wangxy0803/De/paper.pdf

# Design and Kinematic Analysis of a 6-DoF Parallel Robot for Image-guided Surgery

1

st Xiyu Wang
School of Intelligent Systems Engineering Shenzhen Campus of Sun Yat-sen University Shenzhen, China
wangxy623@mail2.sysu.edu.cn

3

rd Zhijie Pan
School of Intelligent Systems Engineering Shenzhen Campus of Sun Yat-sen University Shenzhen, China
panzhj6@mail2.sysu.edu.cn

5

th Ruchi Guo
Department of Mathematics
University of California, Irvine Irvine, USA
ruchig@uci.edu

2

nd Yongyin Ye
School of Intelligent Systems Engineering Shenzhen Campus of Sun Yat-sen University Shenzhen, China
yeyy33@mail2.sysu.edu.cn

4

th Jiangnan Wang
School of Intelligent Systems Engineering Shenzhen Campus of Sun Yat-sen University Shenzhen, China
wangjn229@mail2.sysu.edu.cn

6

th Mengtang Li
School of Intelligent Systems Engineering Shenzhen Campus of Sun Yat-sen University Shenzhen, China
limt29@mail.sysu.edu.cn

Abstract—Image-guided robot based on medical imaging is extensively utilized in the field of surgery due to its inherent characteristics of enhanced precision and larger accessible workspace than surgeons, resulting in reduced harm to patients. Nevertheless, the robots currently employed in image-guided surgery are either insufficiently stable serial robots or parallel robots that pose difficulties in computing direct kinematics. As an improvement to current robot-assisted surgical systems, a compact six degrees of freedom (DoF) decoupled parallel robot has been proposed and corresponding kinematic model has been established. Furthermore, an algorithm based on Newton iterative method is employed to solve the forward kinematics problem. Finally, simulated neurosurgical experiments are carried out to display the trajectory of motion planning and to verify the correctness of kinematics. Experiment results demonstrate that the proposed parallel robot can achieve satisfactory performance.

Index Terms—Image-guided robot; Parallel robot; Robot kinematics.

I. INTRODUCTION
Image-guided surgery is considered a multidisciplinary field that combines real-time imaging techniques with surgical interventions to enhance the precision and accuracy of surgical procedures. Compared with traditional surgery limited by the inadequacies of human visualization and dexterity, the utilization of various imaging modalities such as CT and MRI offers several potential benefits, including improved surgical accuracy, reduced invasiveness, minimized tissue damage, shorted

This project is funded by the Foundation for Shenzhen Science and Technology Program (Grant No. RCBS20221008093104018). Wang, X. and Ye, Y. contributed equally. Li, M., IEEE Member, is the corresponding author.

procedure duration and enhanced patient safety [1]. Hence, it has been widely applied in neurosurgery [2], orthopedics [3] and other medical specialties.
Advances in image-guided surgery are also fueling the drive for robotics as robots augment the capabilities of surgeons and improve the overall surgical workflow. Firstly, robots can provide high levels of precision and accuracy in executing surgical tasks with their ability to perform fine movements and their inherent stability [4]. Moreover, robots can be designed with multiple degrees of freedom and flexible joints, allowing them to access difficult-to-reach areas within a patient’s body [4]. Combined medical robotics with existing imaging modalities, several image-guided robots were proposed and proved to be feasible and accurate. Stoianovici designed a 6-DoF robot mounted on a CT-scanner which was distinguished another by its decoupled motion capability [5]. As better imaging quality and less ionizing radiation are provided by MRI, an MR-compatible assistance system named INNOMOTION with five pneumatically driven DoFs and two adjustments for prepositioning was proposed by Melzer [6]. Figure 1 draws the general workflow of image-guided robot system. Reflecting on the research conducted over the past few decades, the study and development of medical image-guided surgical robots have mostly been associated with robotic arms, which are categorized as serial robots in the field of robotics. However, due to the high accuracy requirement in robotic surgery, parallel robots are superior to their serial counterparts from this aspect. Parallel robots typically have a higher stiffness and rigidity, allowing them to maintain better positional

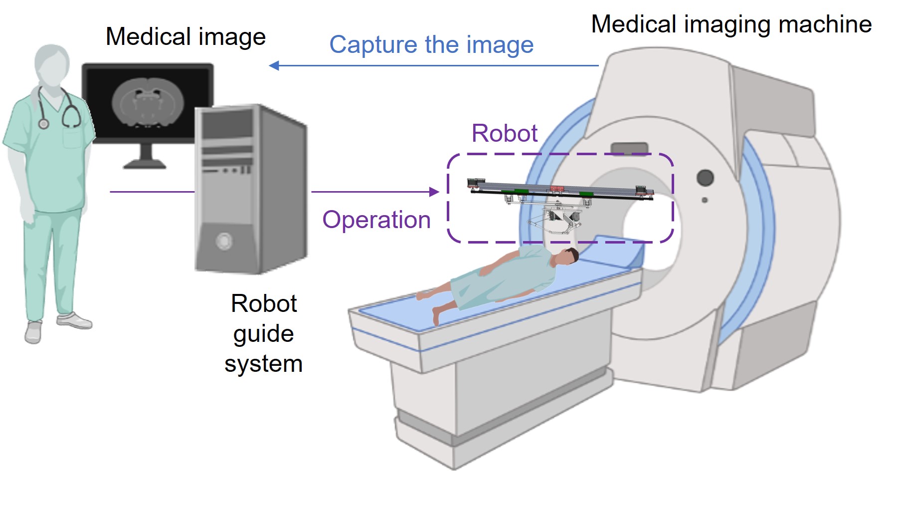
[picture p1: figure]

Fig. 1. Illustration of the usage scenario of image-guided robot system.

accuracy and repeatability. Besides, the redundant connections and multiple supporting joints contribute to the ability to withstand external forces and maintain stability even in the event of component failures [7]. Considering aforementioned advantages, researchers developed several parallel robots for image-guided surgeries. Su proposed a reconfigurable manipulator utilizing parallel mechanism under MRI guidance [8]. Li developed a 6-DoF parallel robotic assistant including a remotely actuated needle driver module and a needle alignment module for MRI-guided low back pain injection [9].

Nevertheless, parallel robots have not gained widespread recognition in the field of image-guided surgery. One possible reason behind is the challenging nature of solving their forward kinematics, which is pivotal in feedback control and motion planning. As a result of the intricate geometry and redundancy of parallel robots, the mathematical equations required to accurately compute the forward kinematics become highly nonlinear and often involve complex trigonometric functions [10]. According to the existing literature, the current methods for the parallel robot’s forward kinematics can be classified into four categories: analytical approaches with highly coupled nonlinear equations that hard to solve [11], numerical methods with the difficulty of choosing the initial value [12], extra-sensors approaches limited by the measurement and assembly error [12], artificial intelligence methods in dire need of investigation but hard to balance the computational accuracy and efficiency [13].

To tackle the aforementioned issues, this paper proposes a novel robot system for image-guided surgery applications in the future, combining the stability advantage of parallel robots and the large-workspace feature of serial robots. This device can promisingly serve as a versatile robotic platform for image-guided surgery, rather than being specific to a particular type of procedure. The rest of the paper is arranged as follows. Section II introduces the mechanical design of the proposed robot, along with geometry and mobility analysis. Section III presents inverse kinematics modeling, followed by forward kinematics analysis using Newton numerical method. Section IV establishes simulation verification of the parallel robot and Section V draws conclusive remarks.

II. MECHANICAL DESIGN

A. Robot Description

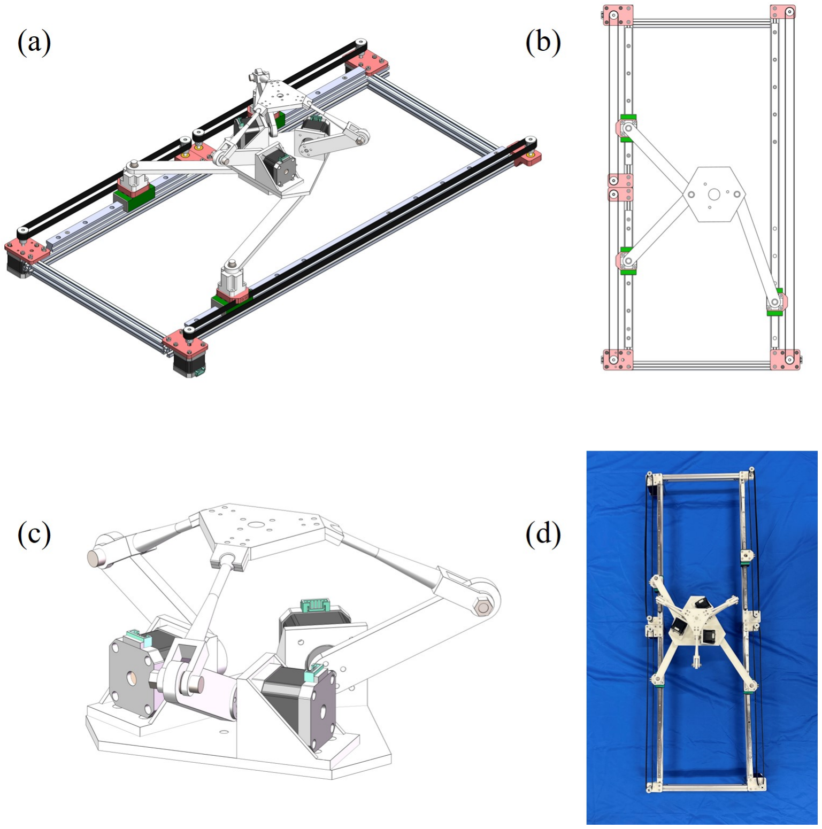
[picture p2: figure]

Fig. 2. (a) CAD design of the proposed robot. (b) Bottom layer: a sliding rail parallel module. (c) Top layer: a 3-RRS parallel module. (d) Prototype of the proposed robot.

As shown in Fig.2, the robot proposed in this paper includes two modules that effectively expand its operational range, allowing for a larger workspace while occupying a smaller system size. The bottom layer is a sliding rail parallel module controlled by three actuators to provide the hexagonal base with translations along x and y directions and rotation around z direction. This hexagonal platform is connected by two rods from one side of the rails at a common joint and one single rod from the other side at a symmetrical position. With certain combinations of actuator displacements, translations and rotations of the hexagonal platform can be achieved via the bottom 3-PRR module. The top layer features a classical 3-RRS architecture. Each chain consists of two links with one spherical passive joint, one revolute passive joint and one revolute active joint. The three revolute active joints are controlled to actuate the end effector platform, achieving rotations around x and y directions and translation along z direction. A noteworthy feature of the proposed robot is that the bottom and the top layers are fundamentally decoupled, facilitating the robot kinematic modeling.

B. Mobility Analysis

The mobility of a parallel robot can be calculated by using Gru¨bler’s formula:
F = m(N − 1 − J) +Xn

i=1

fi

where m represents the degrees of freedom associated with the motion space, N denotes the total number of rigid bodies present in the mechanism, J represents the overall count of joints within the system, and each joint i possesses a degree of freedom denoted by fi
As the proposed parallel robot is eventually a decoupled system, the system degree of freedom can be analyzed with respect to two distinct modules. The bottom 3-PRR planar parallel module works in a m = 3 space, N = 8, J = 9 and Pn
i=1 fi = 9. Then the DoF of the bottom module is F = m(N − 1 − J) + Pn
i=1 fi = 3(8 − 1 − 9) + 9 = 3. From a visual perspective, the operation of the motors induces movement in the three joints, thereby causing positional adjustments of the platform. Consequently, this leads to translational displacements along the x and y axes, as well as rotational motion around the z axis. And the top 3-RRS parallel module works in a m = 6 space, N = 8, J = 9 and Pn
i=1 fi = 15. Hence the DoF of the top module is F = m(N − 1 − J) + Pn
i=1 fi = 6(8 − 1 − 9) + 15 = 3. In a similar manner, the motors actuate the movement of the three joints, causing the passive joints to induce positional changes in the platform. This results in rotational motion along the x and y axes, as well as translational displacement along the z axis. Conclusively, the entire system is capable of achieving 6-DoF motions for the end effector platform.

III. KINEMATIC ANALYSIS
Analogous to the previous section, we also leverage the system’s partially decoupled nature to separately analyze the kinematics of the bottom and top modules.
A. The Bottom 3-PRR Sliding Rail Parallel Module

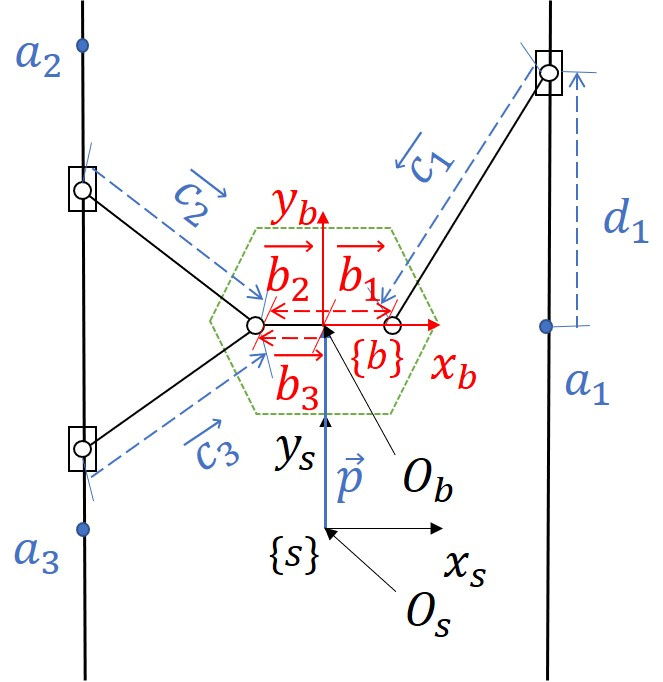
[picture p3: figure]

Fig. 3. Kinematic diagram of the bottom 3-PRR parallel module.

1) Inverse Kinematics: The configuration of the bottom module can be explained by the loop closure method. As shown in Fig.3, a fixed frame {s} is positioned at the spot Os, while the body frame {b} is positioned at the spot Ob on the hexagonal base. L refers to the width between the two rails. The distance moved by each active joint relative to the initial reference vector ai

is represented as di

, i = 1, 2, 3. Denote
the coordinate representation of the origin of {b} in {s} by p. Let φ be rotational angle of the body frame {b} relative to the fixed frame {s}. Further, define ci as a vector aligned with the direction of the rod and having the same length as the rod, and bi as the vector from Ob to the joint on the hexagonal platform.

Note that both b2 and b3 refer to the identical vector. The inverse kinematics problem is to determine d = (d1, d2, d3) from the given values of T sb ∈ SE(3). The homogeneous coordinate transformation matrix T sb from the fixed frame {s} to the moving coordinate frame {b} is:

T sb =

Rsb | p
0 | 1
, Rsb =

cφ −sφ 0
sφ | cφ | 0
0 | 0 | 1
- , p =

px
py
0

where s and c stand for sin and cos respectively, Rsb is the rotation matrix defining the orientation of the body frame {b} with respect to the fixed frame {s}. From these definitions, clearly we have:

di = p + bi − ai − ci | (1)

Note that ai

, bi and ||ci

|| are all constant, and all the vectors are expressed in {s}-frame coordinates with the exception of bi
. So combining with the rotation matrix, Eq.(1) can be illustrated as follow:

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
cφ −sφ 0
sφ | cφ | 0
0 | 0 | 1

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
- (2)

for i = 1, 2, 3. Also, since ||ci

|| is constant and dix = 0, we have

dix = px + cφbix − sφbiy − aix − cix = 0 | (3)
diy = py + sφbix + cφbiy − aiy − ciy | (4)

c

2
ix + c

2
iy = ||ci

||²
(5)

for i = 1, 2, 3. Formulated as above, the inverse kinematics of the bottom sliding rail module is readily calculable: given values for (px, py, φ), the active joints’ displacement can be directly computed from Eqs.(3)-(5).
2) Forward Kinematics: On the contrary, the forward kinematics problem involves determining the position and orientation of the body frame T sb, given the known displacement of the active joints d = (d1, d2, d3). By incorporating the tangent half-angle substitution, Eqs.(3)-(5) can be reformulated as polynomial equations in terms of t as follows:

dix + aix + cix = px +

1 − t

2
1 + t

2

bix −

2t
1 + t

2

biy (6)

diy + aiy + ciy = py +

2t
1 + t

2

bix +

1 − t

2
1 + t

2

biy (7)

c

2
ix + c

2
iy = ||ci

||²
(8)
t = tan(φ/2) | (9)

for i = 1, 2, 3. Through some mathematical manipulations, Eqs.(6)-(9) can be reduced to a simplified univariate 8thdegree polynomial with respect to t, indicating the forward kinematics of the bottom module can have at most eight solutions. But due to the specific design of the bottom module, where the two rods on the left are of equal length and the range of motion for the rod on the right is limited to the upper plane, the eight possible solutions can be reduced to two. Hence, when utilizing forward kinematics to determine the pose of the end-effector T sb under the current displacements of the active joints, it is important to take into account the robot’s previous state in order to eliminate alternative forward kinematics solutions. By selecting a solution that is close to the previous state, we can estimate the forward kinematics of T sb accurately for the current configuration.

B. The Top 3-RRS Parallel Module

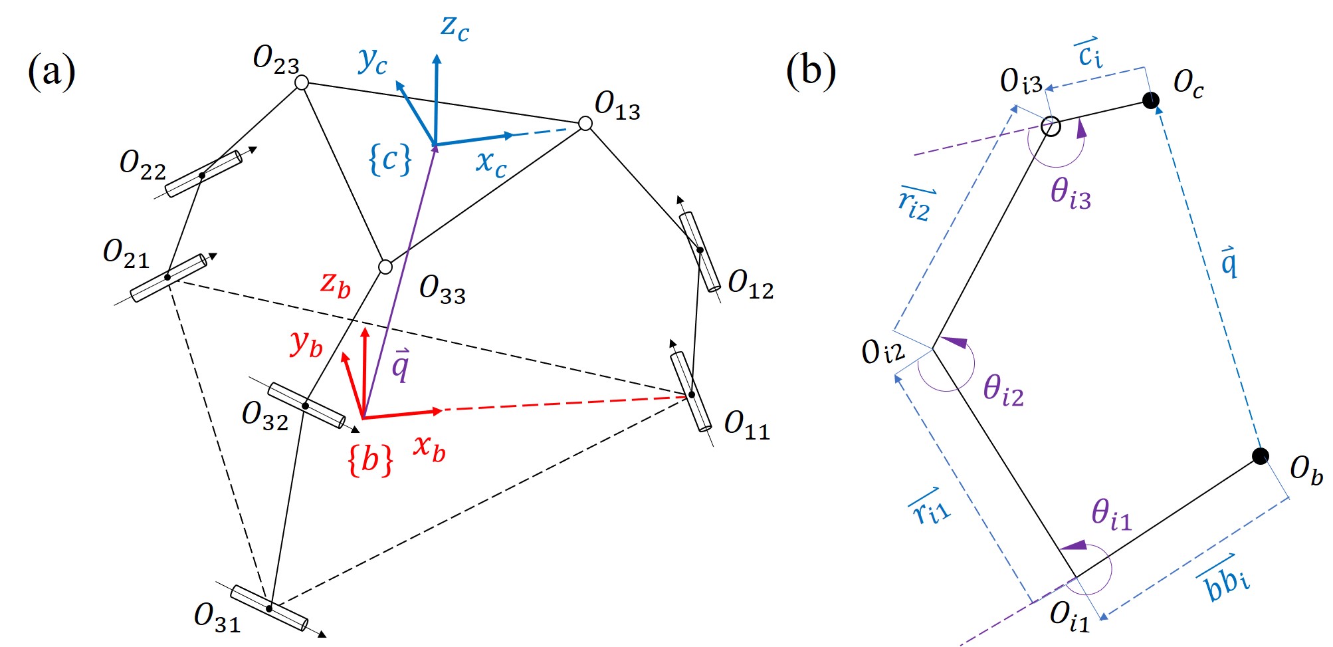
[picture p4: figure]

Fig. 4. (a) Kinematic diagram of the top 3-RRS parallel module. (b) Simplified model of a closed-loop joint system.

1) Inverse Kinematics: Compared to the distinctive design of the bottom layer, the top 3-RRS parallel module is a more commonly encountered mechanism [14]. As shown in Fig.4, the body frame {b} is the same as the bottom module, while the {c}-frame coordinate system is attached at the spot Oc on the moving platform. △O11O21O31 and △O13O23O33 are two equilateral triangles. Denote the vectors from Ob to Oi1 by bbi

, for i = 1, 2, 3. And the xb-axis is chosen to be along with bb1. Similarly, ci represent the vectors from Oc to Oi3, while xc-axis is chosen to be along with c1. The position vector that defines the location of the upper coordinate frame {c} with respect to the body frame {b} is q. ri1 =

−−−−→ Oi1Oi2 are

the lower limb vectors, controlling by actuators. ri2 =

−−−−→ Oi2Oi3

represent the upper limb vectors, but they are passive joints’ parameters. Let θij , for i = 1, 2, 3, j = 1, 2, 3 denote the angle of a joint, while ψ = (ψx, ψy, ψz) corresponds to the angle of rotation. The inverse kinematics problem is to determine θi1 = (θ11, θ21, θ31) from the given values of T bc ∈ SE(3).Then the homogeneous coordinate transformation matrix T bc from the body frame {b} to the moving coordinate frame {c} can be shown:

T bc =

Rbc | q
0 | 1
, q =

qx
qy
qz
- ,

Rbc = Rx · Ry · Rz

=

1 | 0 | 0
0 cψx | −sψx
0 sψx | cψx
cψy | 0 sψy
0 | 1 | 0
−sψy | 0 cψy
cψz | −sψz | 0
sψz | cψz | 0
0 | 0 | 1

where Rbc is the rotation matrix defining the orientation of the upper frame {c} with respect to the body frame {b}.

Due to the constraints imposed by the geometric structure, the top layer has only three parameters qz ψx ψy that can be freely adjusted, while the remaining three parameters qx qy ψz are determined by the bottom module, as mentioned above. Therefore, the following will elucidate some constraints on the parameters in order to analyze kinematics.
−−−−→ ObO13 = q + c1 ⇒

O13,x O13,y O13,zT

=

Oc,x Oc,y Oc,zT
+ Rbc · Rz(α1)

rc 0 0T

(10)

−−−−→ ObO23 = q + c2 ⇒

O23,x O23,y O23,zT

=

Oc,x Oc,y Oc,zT
+ Rbc · Rz(α2)

rc 0 0T

(11)

−−−−→ ObO33 = q + c3 ⇒

O33,x O33,y O33,zT

=

Oc,x Oc,y Oc,zT
+ Rbc · Rz(α3)

rc 0 0T

(12)

where rc is the radius of the circumscribed circle of the top layer and α1,2,3 = 0,

2π
3

,

4π
3

. From Eqs.(10)-(12) can we have the following results:

Oc,y = −rc(cψzsψxsψy + cψxsψz) | (13)

Oc,x = −

rc
2

(cψycψz − cψxcψz + sψxsψysψz) (14)

ψz = tan⁻¹
(

−sψxsψy
cψx + cψy
) | (15)

for cψx + cψy ̸= 0. From these definitions, clearly we have

q + ci = bbi + ri1 + ri2 | (16)

for i = 1, 2, 3. Then using the right-hand side of the Eq.(16) and resolving into x, y and z components, we have:

x : ||ri2||cθi2cαi = Oi3,x − cαi(rb + ||ri1||cθi1) | (17)
y : ||ri2||cθi2sαi = Oi3,y − sαi(rb + ||ri1||cθi1) | (18)
z : ||ri2||sθi2 = −Oi3,z − ||ri1||sθi1 | (19)

for i = 1, 2, 3. rb is the radius of the circumscribed circle of the bottom layer. By applying certain mathematical operations to Eq.(17) and Eq.(19), the following results can be derived:

θi1 = 2tan⁻¹
(

−Bi ±

p
A²

i + B²

i − C²
i
Ci − Ai

) (20)

where
Ai = 2||ri1||cαi(rbcαi − Oi3,x)

Bi = 2||ri1||Oi3,zc

2αi

Ci = O

2
i3,x−2rbOi3,xcαi+c

2αi(r

2

b +||ri1||²−||ri2||²+O

2
i3,z)

for Ci − Ai ̸= 0, i = 1, 2, 3. As stated above, the inverse kinematics of the top 3-RRS parallel module can be easily calculated. Given the values for (ψx, ψy, qz), the displacements of the active joints can be directly computed using Eq.(20).

2) Forward Kinematics: In forward kinematics, the goal is to find the configuration of the end-effector T bc ∈ SE(3), given the values of the active joints θi1, for i = 1, 2, 3. However, since multiple sets of passive joints θi2, for i = 1, 2, 3, corresponding to the same combination of active joints but different end-effector configurations, it is necessary to solve for the passive joints first in order to determine a unique end-effector configuration.

D1 = ||bb1 + r11 + r12 − (bb2 + r21 + r22)||² − 3r

2
c

(21)

D2 = ||bb1 + r11 + r12 − (bb3 + r31 + r32)||² − 3r

2
c

(22)

D3 = ||bb2 + r21 + r22 − (bb3 + r31 + r32)||² − 3r

2
c

(23)

Eqs.(21)-(23) describe the geometric constraints of the top module, which can be transformed into expressions involving the passive joints variables θi2 combining Eq.(24):

r12 =

||r12||cθ12
0
−||r12||sθ12
- , r22 =

−
1/2||r22||cθ22
√
3
2

||r22||cθ22
−||r22||sθ22

- ,

r32 =

−

1/2||r32||cθ32
−

√
3
2

||r32||cθ32
−||r32||sθ32

(24)

To address the issue of multiple solutions in forward kinematics and achieve motion planning, it is necessary to select a solution that closely matches the desired trajectory from the multiple solutions. In this process, similar to the Newton’s method for finding the closest solution [15], an iterative computation is performed to select the solution that converges to the correct one. Firstly, we need to establish an iterative equation for the given problem in θi2 = (θ12, θ22, θ32):

θ

(k+1)
i2 = θ

(k)
i2 − J

−1F(θ

(k)
i2
) | (25)

where

F =

D1
D2
D3
- , J =

∂D1
∂θ12

∂D1
∂θ22

∂D1
∂θ32
∂D2
∂θ12

∂D2
∂θ22

∂D2
∂θ32
∂D3
∂θ12

∂D3
∂θ22

∂D3
∂θ32

The matrix J represents the Jacobian matrix of the top 3-RRS parallel module, establishing the relationship between the velocity of the moving platform and the driving angles of the top parallel module when the passive angles θi2 = (θ12, θ22, θ32) are utilized as driving angles [16]. The forward kinematics solution that corresponds to the actual motion can therefore be obtained. Detailed workflow is shown in Fig.5.

IV. SIMULATION VERIFICATION
When the parallel robot is processing, the trajectory tracking of the proposed parallel robot needs to be recorded during the processing experiment to validate the accuracy of forward kinematics. At first, the motion planning of the bottom 3-PRR parallel module is carried out in a simulated neurosurgical

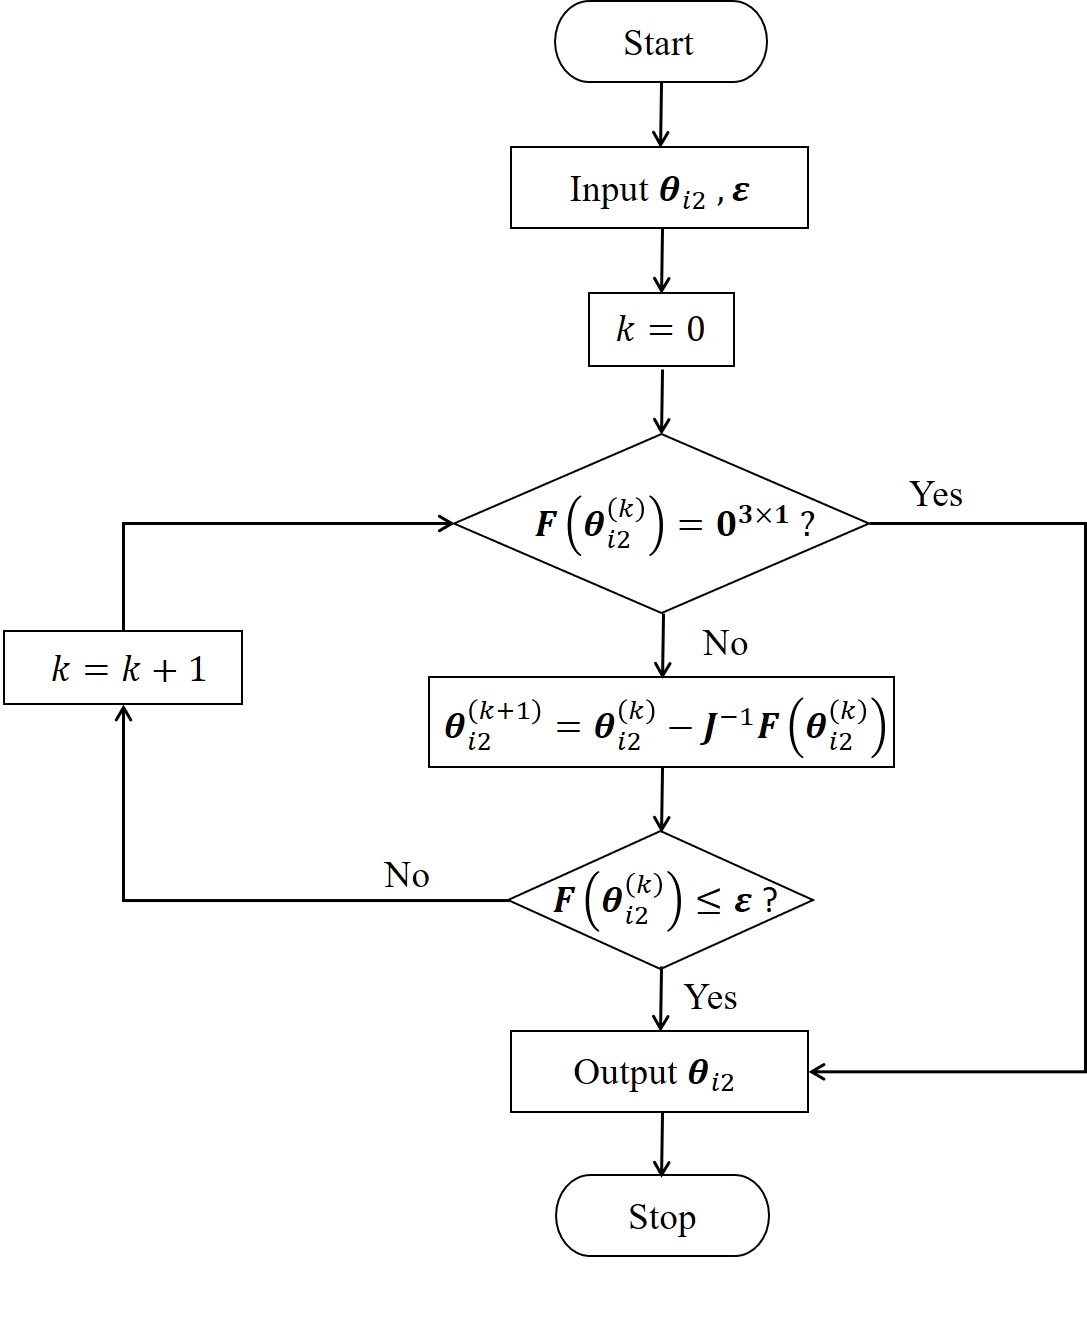
[picture p5: figure]

Fig. 5. Flowchart for Newton method in solving for passive joints.

procedure and the displacement tracking errors between the commanded position trajectory and simulated position trajectory are shown. Then, the top 3-RRS parallel module also undergoes the same experiment and the puncture needle is introduced into the experiment to complete the entire process of motion planning and surgical puncture. Robot specification parameters are listed in Table I.

TABLE I

ROBOT SPECIFICATION PARAMETER

Parameter | value(mm) | Parameter | value(mm)
rb | 55.4256 | ||c1|| | 250
rc | 60 | ||c2|| | 200
||rij || | 200 | ||c3|| | 200
L | 320 | ||bi|| | 50

As depicted in Fig.6(a), considering only the movement of the bottom module, a trajectory is defined from the initial position to the target position. By employing inverse kinematics, the displacement of the active joints are calculated, representing the actual motor control displacement in real scenarios. Subsequently, forward kinematics is used to validate the position that the bottom layer will reach in practical circumstances. After conducting a comparative analysis of trajectory errors, as illustrated in Fig.6, the average positional error px of the bottom module is 0.322 mm, with an average positional error py of 0.187 mm. Additionally, the average angular error φ is calculated to be 0.393°.
Fig.7(a) demonstrates the sequence in which the top layer initiates its movement after the bottom module reaches the target position and remains stationary. Simultaneously, a final simulation of needle insertion is performed. Following a similar methodology applied to the bottom layer, the active joints’ variations of the top module are computed using inverse kinematics, and the accuracy of the end-effector pose is then verified using forward kinematics. As shown in Fig.7(b), the additional three degrees of freedom provided by the top module exhibit the following average errors: 0.0024mm in the

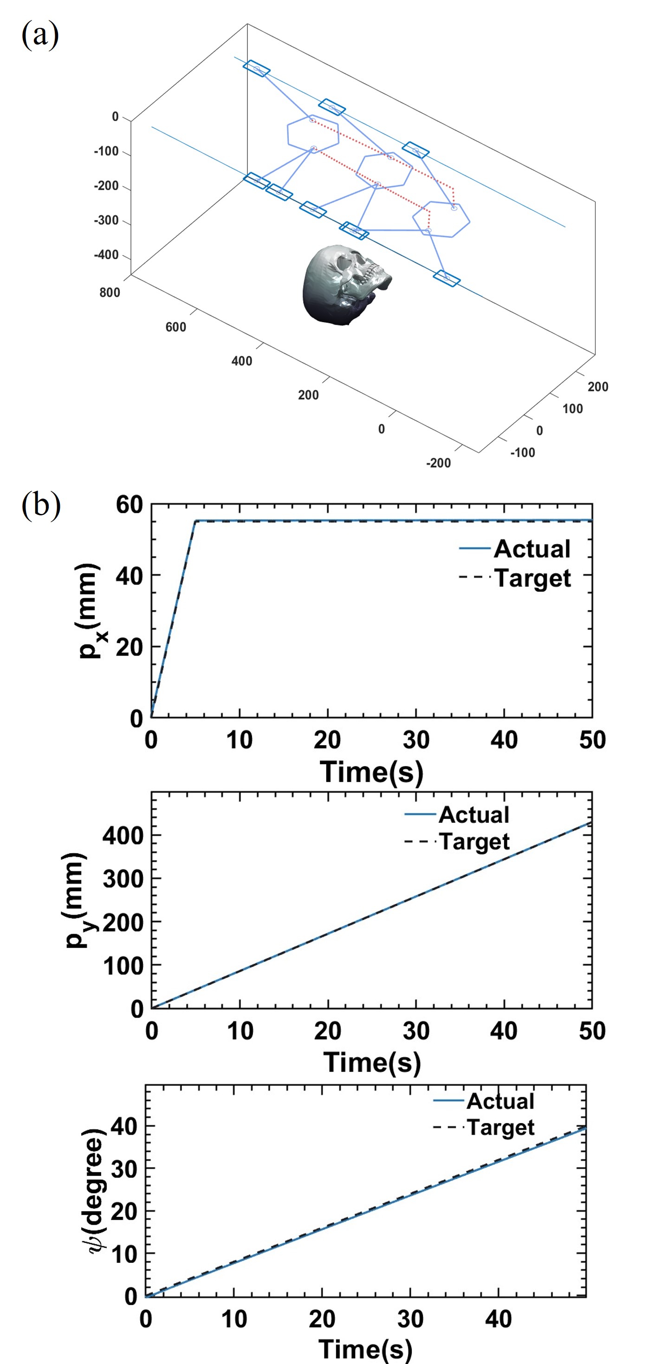
[picture p6: figure]

Fig. 6. (a) Tracking trajectory of the bottom parallel module. (b) Comparison between the commanded position trajectory and simulated position trajectory of the bottom parallel module.

qz direction, 0.008° in the ψx direction, and 0.0046° in the ψy direction.

V. CONCLUSION
The present study introduces a 6-DoF parallel robot specifically designed for image-guided surgeries. It incorporates a rail sliding architecture to expand the workspace and a mobile module to offer steady and dexterous end-effector configurations. The robot consists of two modules that utilize the Newton method in conjunction with the previous state to address the forward kinematics problem. Simulation tests confirm the feasibility and tracking accuracy of the motion planning. The proposed robot demonstrates versatility and can be effectively applied to a wide range of image-guided surgeries, making it a universal image-guided surgical robot. Future work encompasses prototype manufacturing and further optimization of the forward kinematics solution, thereby laying the groundwork for subsequent research on the proposed parallel robot.

REFERENCES

[1] F. Jolesz, Intraoperative Imaging and Image-Guided Therapy. Springer New York, 1 2014.
[2] J. Shapey, T. Dowrick, and et al., “Integrated multi-modality image-guided navigation for neurosurgery: open-source software platform using state-of-the-art clinical hardware.” International journal of computer assisted radiology and surgery, vol. 16, no. 8, p. 1347–1356, 2021.
[3] X. Fan, Q. Zhu, P. Tu, L. Joskowicz, and X. Chen, “A review of advances in image-guided orthopedic surgery,” Physics in medicine and biology, vol. 68, no. 2, 2023.
[4] R. H. Kassamali and B. Ladak, “The role of robotics in interventional radiology: current status.” Quantitative imaging in medicine and surgery, vol. 5, no. 3, p. 340–343, 2015.

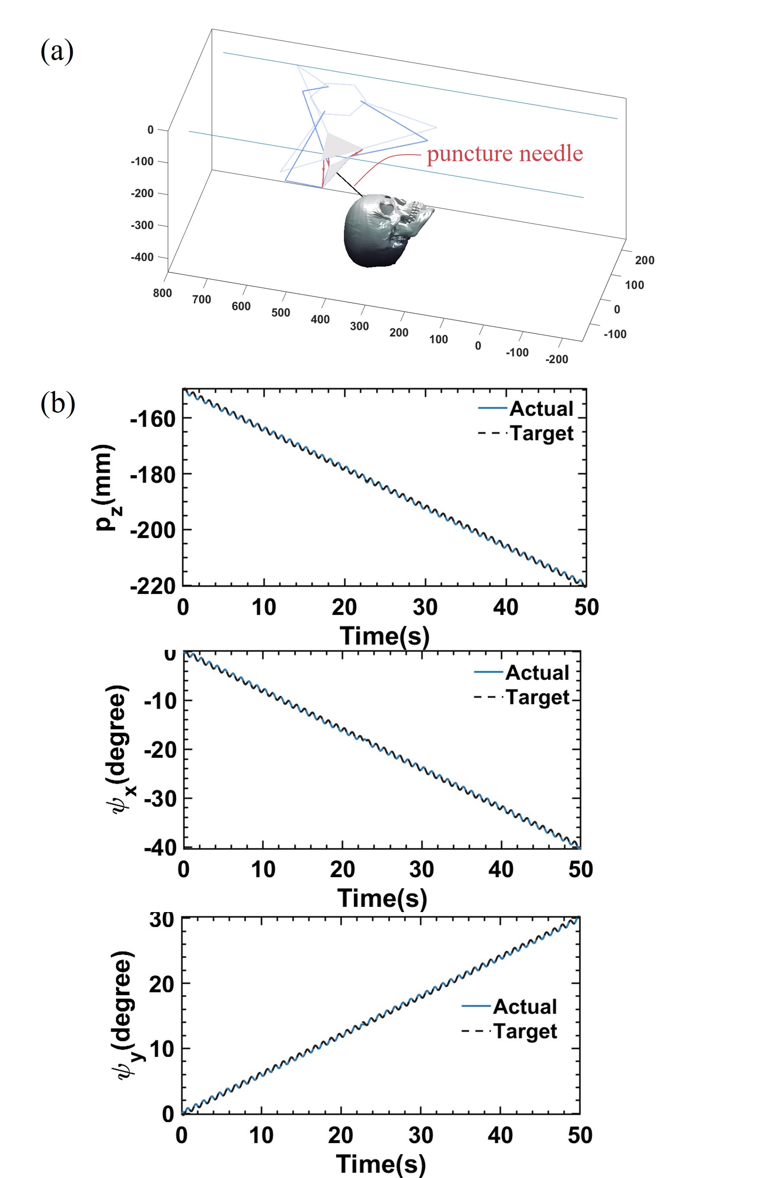
[picture p7: figure]

Fig. 7. (a) Tracking trajectory of the top parallel module and needle insertion.
(b) Comparison between the commanded position trajectory and simulated position trajectory of the top parallel module.
[5] D. Stoianovici, K. Cleary, A. Patriciu, D. Mazilu, A. Stanimir, N. Craciunoiu, V. Watson, and L. Kavoussi, “Acubot: a robot for radiological interventions,” IEEE Transactions on Robotics and Automation, vol. 19, no. 5, pp. 927–930, 2003.
[6] A. Melzer, B. Gutmann, T. Remmele, R. Wolf, A. Lukoscheck, M. Bock,
H. Bardenheuer, and H. Fischer, “Innomotion for percutaneous image-guided interventions,” IEEE Engineering in Medicine and Biology Magazine, vol. 27, no. 3, pp. 66–73, 2008.
[7] C. Gosselin and J.-P. Merlet, Parallel Robots: Architecture, Modeling, and Design. Springer Berlin Heidelberg, 2020, pp. 1–6.
[8] H. Su, I. I. Iordachita, X. Yan, G. A. Cole, and G. S. Fischer, “Reconfigurable mri-guided robotic surgical manipulator: Prostate brachytherapy and neurosurgery applications,” in 2011 Annual International Conference of the IEEE Engineering in Medicine and Biology Society, 2011, pp. 2111–2114.
[9] G. Li, N. A. Patel, W. Liu, D. Wu, K. Sharma, K. Cleary, J. Fritz, and
I. Iordachita, “A fully actuated body-mounted robotic assistant for mri-guided low back pain injection,” in 2020 IEEE International Conference on Robotics and Automation (ICRA), 2020, pp. 5495–5501.
[10] J.-P. Merletl, Parallel Robots. Springer Dordrecht, 7 2006.
[11] E. G. Kalajahi, M. Mahboubkhah, and A. Barari, “Numerical versus analytical direct kinematics in a novel 4-dof parallel robot designed for digital metrology,” IFAC-PapersOnLine, vol. 54, no. 1, pp. 181–186, 2021.
[12] Q. Zhu and Z. Zhang, “An efficient numerical method for forward kinematics of parallel robots,” IEEE Access, vol. 7, pp. 128 758–128 766, 2019.
[13] A. Prado, H. Zhang, and S. K. Agrawal, “Artificial neural networks to solve forward kinematics of a wearable parallel robot with semirigid links,” in 2021 IEEE International Conference on Robotics and Automation (ICRA), 2021, pp. 14 524–14 530.
[14] H. Tetik, “Modelling and control of a 3-rrs parallel manipulator,” 2016.
[15] Y. Ye, J. Yuan, J. Zhang, X. Wu, X. Wang, B. Ding, and M. Li, “Kinematic modeling of an mri-compatible concentric steerable needle robot based on screw theory,” in 2022 China Automation Congress (CAC). IEEE, 2022, pp. 1361–1366.
[16] Y. Du, R. Li, D. Li, and S. Bai, “An ankle rehabilitation robot based on 3-rrs spherical parallel mechanism,” Advances in Mechanical Engineering, vol. 9, 2017.
