wangxy0803/De/code/simulation_pro_2-3.png

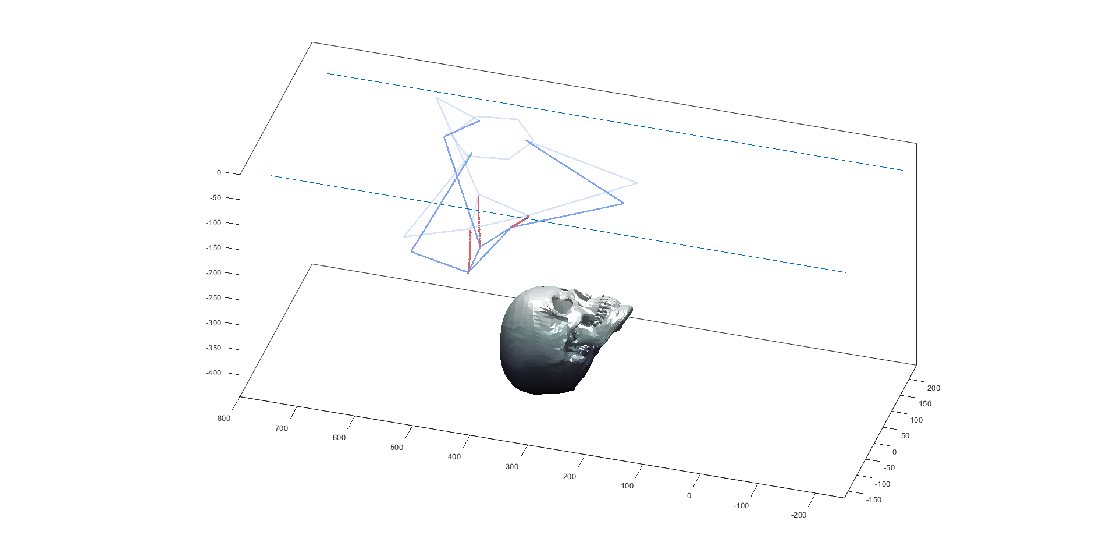
code/simulation_pro_2-3.png
