wangxy0803/De/prototype/连杆.SLDASM

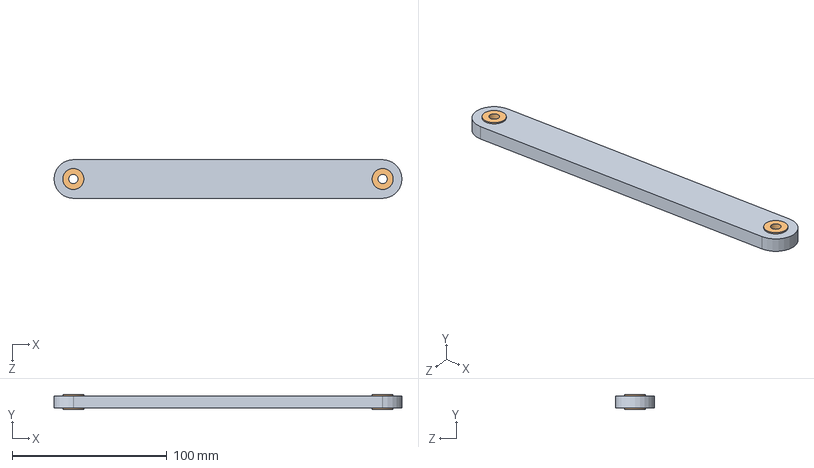
[picture p25: CAD file, 2023-10-09]
prototype/连杆.SLDASM
225.0 x 9.60 x 25.0 mm
连杆1-v1
6-12-4法兰轴承 x 4
