wangxy0803/De/prototype/上平台.SLDASM

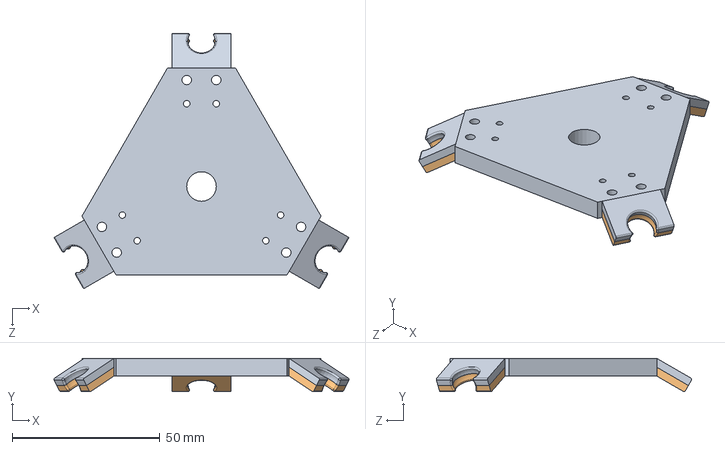
[picture p26: CAD file, 2023-10-09]
prototype/上平台.SLDASM
99.7 x 11.2 x 86.4 mm
platform
球副2 x 3
