wangxy0803/De/prototype/组合-底层平台.sldasm

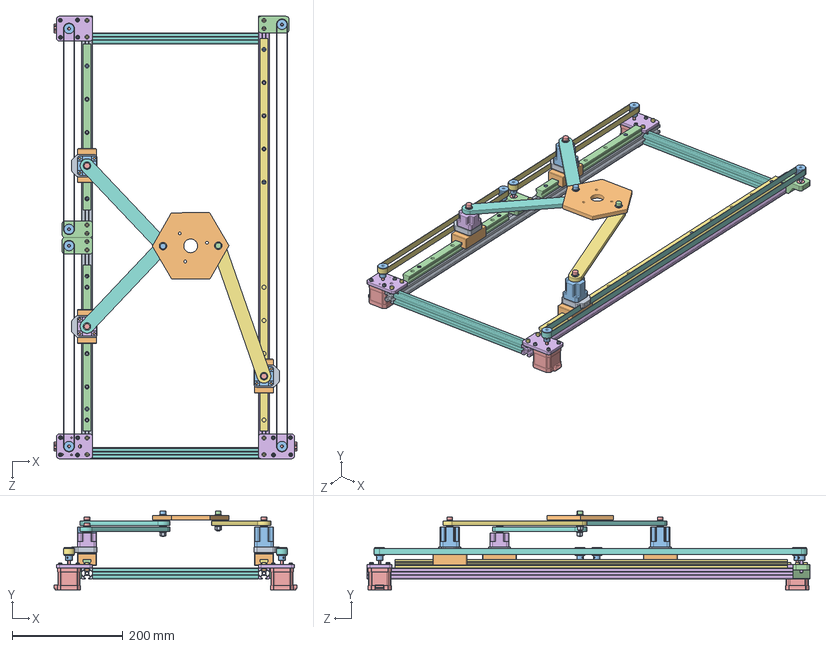
[picture p28: CAD file, 2023-10-09]
prototype/组合-底层平台.sldasm
439.3 x 142.6 x 800.0 mm
400mm20铝型材 x 2
T型螺母-20系列M4x10x6x5 x 18
圆头螺丝M4x16 x 6
直线导轨-HGR15 x 2
42StepMotor40 x 3
42步进电机固定板-v1 x 3
圆头螺丝M4x10 x 12
圆头螺丝M3_x45 x 12
Nut_M3 x 12
Washer_3x7x05 x 12
同步带齿轮10齿 x 6
同步齿轮固定板-v1 x 3
轴承5x14x5 x 6
圆柱轴5x40 x 3
同步皮带 x 2
300mm20铝型材 x 2
滑块固定板-v1 x 3
直线导轨滑块-HGH15四方形 x 3
滑块连接件-高 x 2
6-12-4法兰轴承 x 22
M6垫片 x 13
滑块连接件
长连杆1-v1
连杆1-v1 x 2
M6防松螺母 x 5
底部平台-v1
M6-40螺丝
M6-30螺丝
M6-35螺丝 x 3
800mm20铝型材
直线导轨-HGR15-长
同步皮带-长
