wangxy0803/De/prototype/长连杆.SLDASM

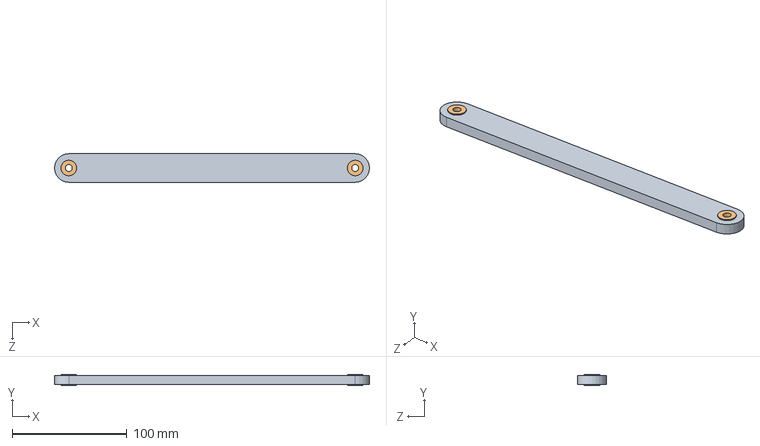
[picture p29: CAD file, 2023-10-09]
prototype/长连杆.SLDASM
275.0 x 9.60 x 25.0 mm
长连杆1-v1
6-12-4法兰轴承 x 4
