wangxy0803/De/prototype/底部运动平台.SLDASM

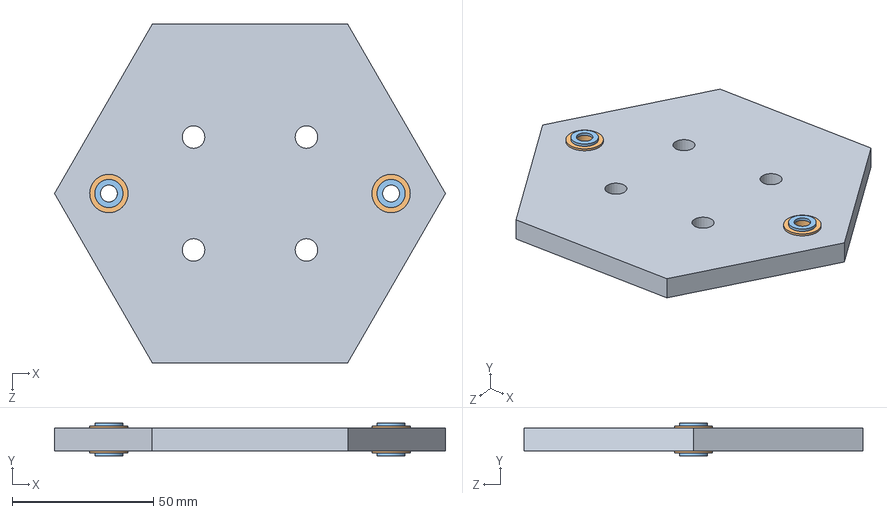
[picture p32: CAD file, 2023-10-09]
prototype/底部运动平台.SLDASM
138.6 x 11.6 x 120.0 mm
底部平台-v1
6-12-4法兰轴承 x 4
M6垫片 x 4
