wangxy0803/De/prototype/组合-线性关节-v2-组合用.SLDASM

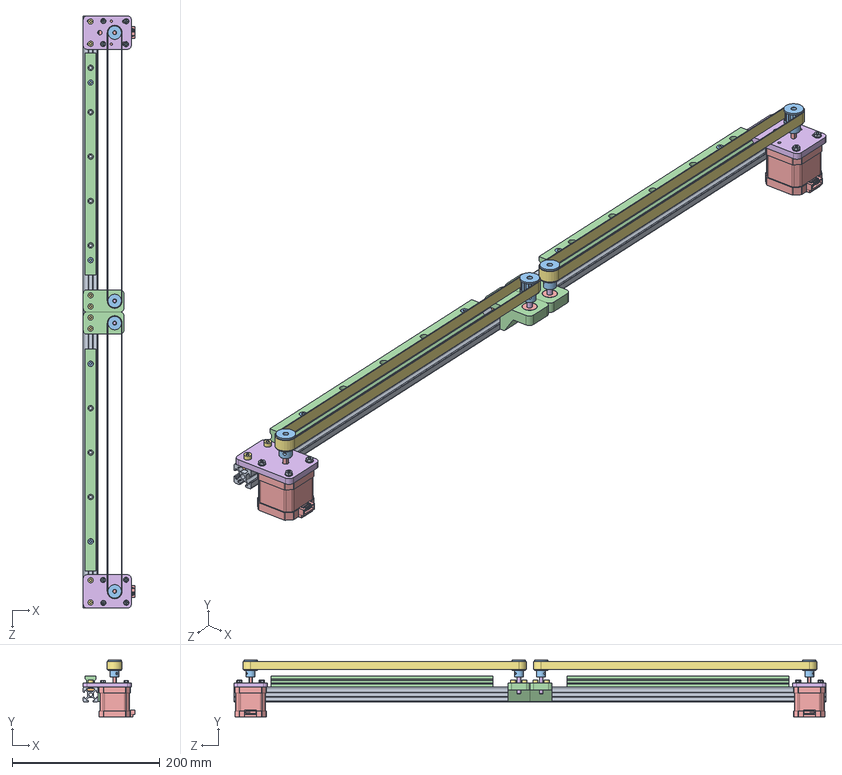
[picture p33: CAD file, 2023-10-09]
prototype/组合-线性关节-v2-组合用.SLDASM
69.7 x 76.5 x 800.0 mm
400mm20铝型材 x 2
T型螺母-20系列M4x10x6x5 x 12
圆头螺丝M4x16 x 4
直线导轨-HGR15 x 2
42StepMotor40 x 2
42步进电机固定板-v1 x 2
圆头螺丝M4x10 x 8
圆头螺丝M3_x45 x 8
Nut_M3 x 8
Washer_3x7x05 x 8
同步带齿轮10齿 x 4
同步齿轮固定板-v1 x 2
轴承5x14x5 x 4
圆柱轴5x40 x 2
同步皮带 x 2
