wangxy0803/De/prototype/机器人.SLDASM

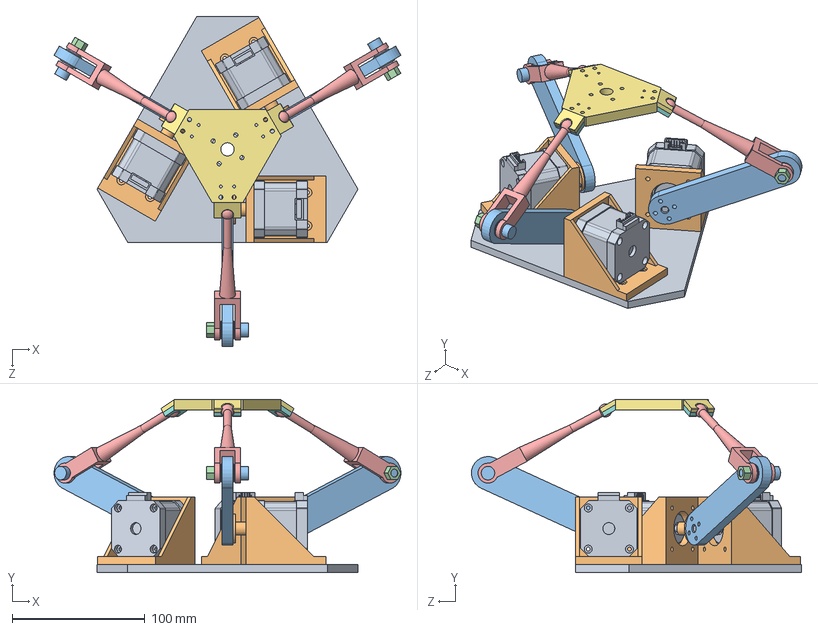
[picture p34: CAD file, 2023-10-09]
prototype/机器人.SLDASM
261.0 x 130.4 x 248.4 mm
定平台2
法兰盘 x 3
摇臂 x 3
6-12-4法兰轴承 x 6
球关节摇臂 x 3
M6垫片 x 6
platform
球副2 x 3
42步进电机 x 3
步进电机支架 x 3
M6-25螺丝 x 3
M6防松螺母 x 3
