wangxy0803/De/prototype/组合-线性关节-v1-组合用-长.SLDASM

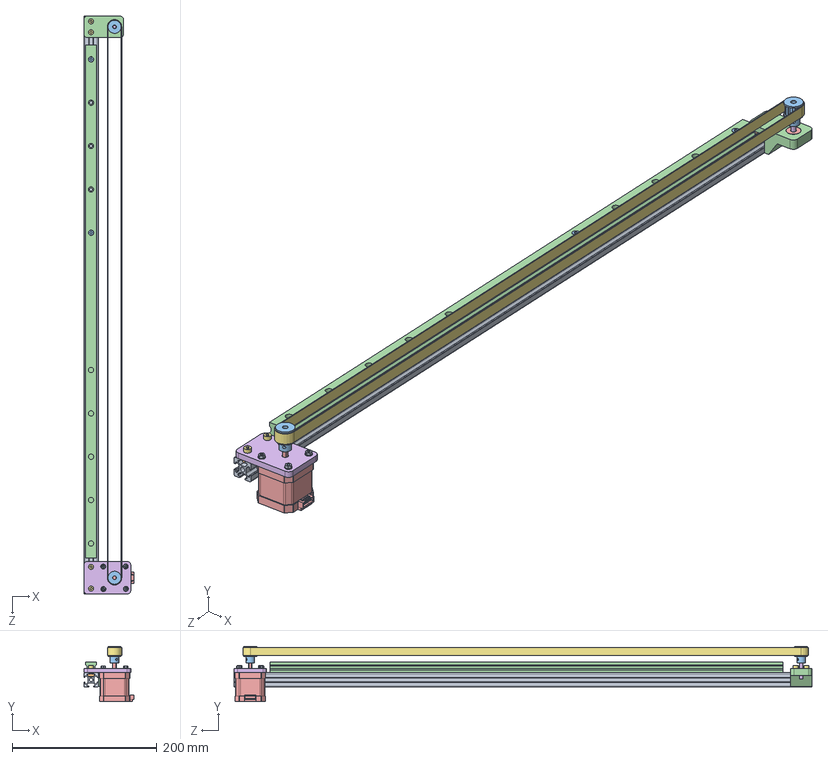
[picture p35: CAD file, 2023-10-09]
prototype/组合-线性关节-v1-组合用-长.SLDASM
69.7 x 76.5 x 800.0 mm
800mm20铝型材
T型螺母-20系列M4x10x6x5 x 6
圆头螺丝M4x16 x 2
直线导轨-HGR15-长
42StepMotor40
42步进电机固定板-v1
圆头螺丝M4x10 x 4
圆头螺丝M3_x45 x 4
Nut_M3 x 4
Washer_3x7x05 x 4
同步带齿轮10齿 x 2
同步齿轮固定板-v1
轴承5x14x5 x 2
圆柱轴5x40
同步皮带-长
