wangxy0803/De/prototype/组合-滑块-v1.SLDASM

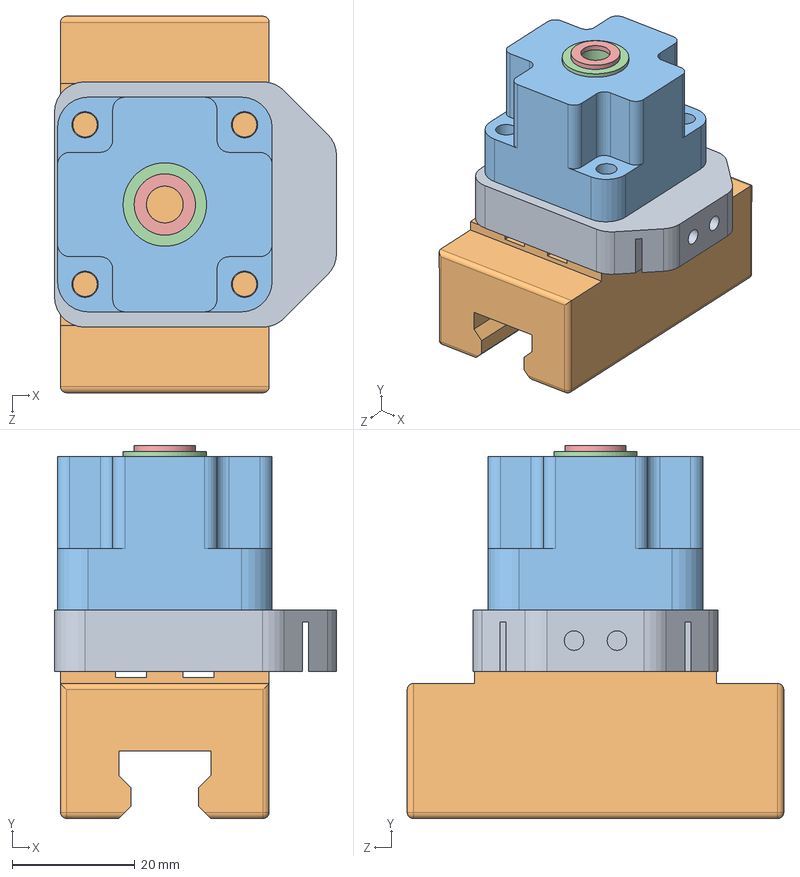
[picture p36: CAD file, 2023-10-09]
prototype/组合-滑块-v1.SLDASM
46.0 x 60.8 x 61.4 mm
滑块固定板-v1
直线导轨滑块-HGH15四方形
滑块连接件
6-12-4法兰轴承 x 2
M6垫片
