wangxy0803/De/code/skull.stl

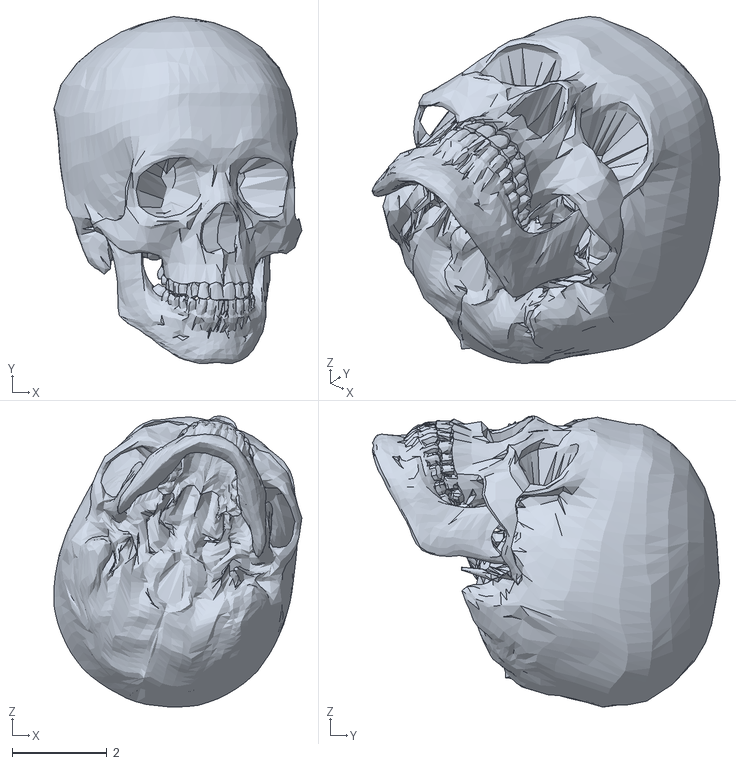
[picture p37: CAD file, 2023-10-09]
code/skull.stl
5.23 x 7.32 x 6.14
