wangxy0803/De/code/stlTools/femur_binary.stl

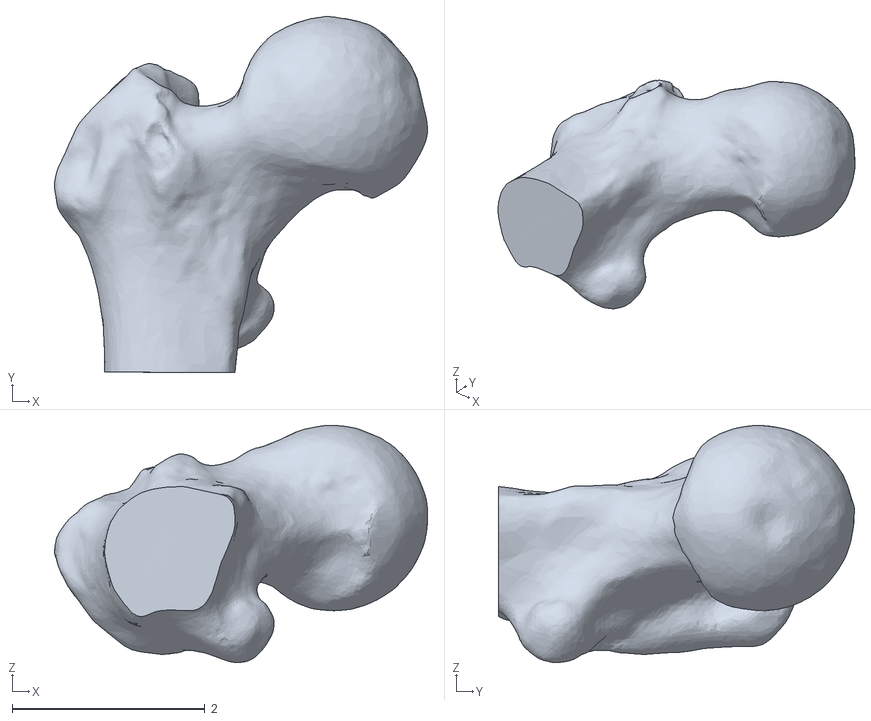
[picture p38: CAD file, 2023-10-09]
code/stlTools/femur_binary.stl
3.87 x 3.70 x 2.46
