wangxy0803/De/code/stlTools/sphere_ascii.stl

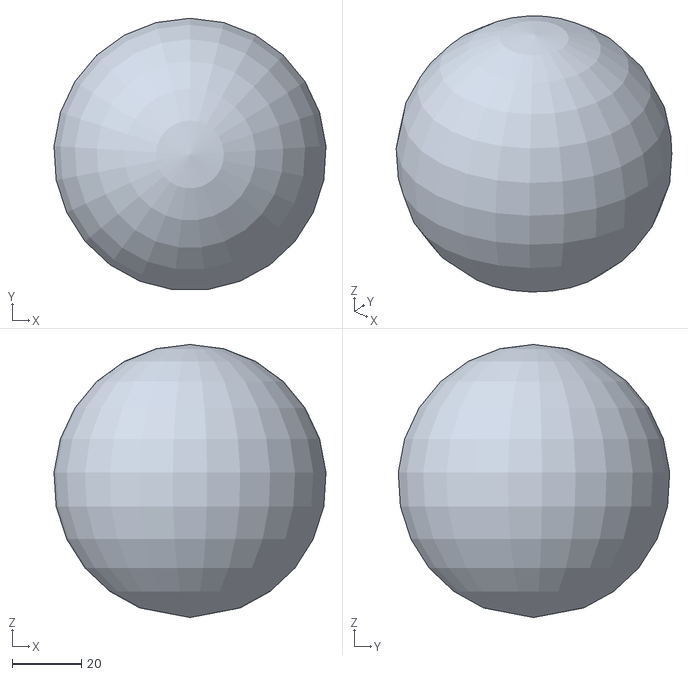
[picture p39: CAD file, 2023-10-09]
code/stlTools/sphere_ascii.stl
78.4 x 78.3 x 78.7
