wangxy0803/De/prototype/11-5.2-10隔离柱.SLDPRT

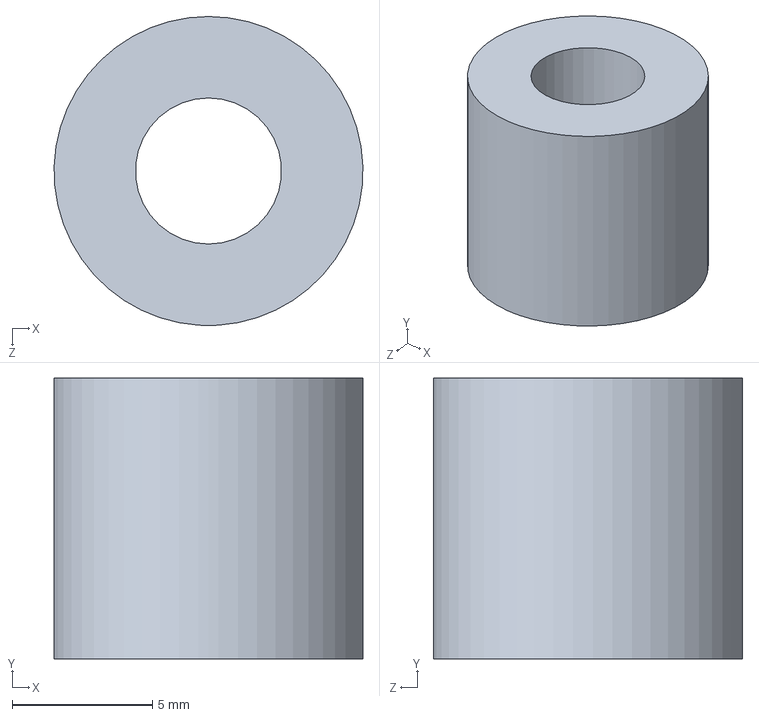
[picture p40: CAD file, 2023-10-09]
prototype/11-5.2-10隔离柱.SLDPRT
11.0 x 10.0 x 11.0 mm
