wangxy0803/De/prototype/直线导轨-HGR15-长.SLDPRT

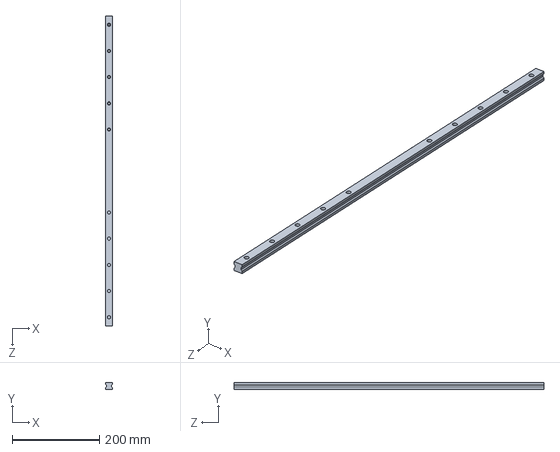
[picture p41: CAD file, 2023-10-09]
prototype/直线导轨-HGR15-长.SLDPRT
15.0 x 15.0 x 710.0 mm
