wangxy0803/De/prototype/42StepMotor40.SLDPRT

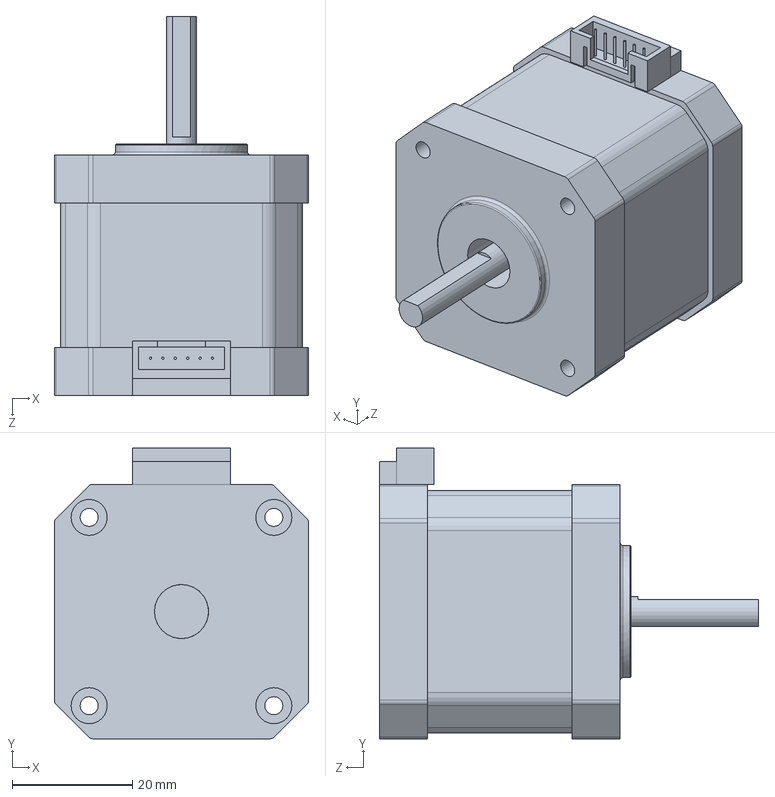
[picture p42: CAD file, 2023-10-09]
prototype/42StepMotor40.SLDPRT
42.3 x 48.3 x 63.0 mm
