wangxy0803/De/prototype/长连杆1-v1.SLDPRT

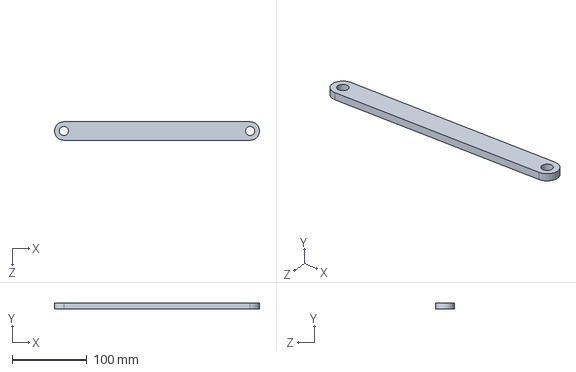
[picture p43: CAD file, 2023-10-09]
prototype/长连杆1-v1.SLDPRT
275.0 x 8.00 x 25.0 mm
