wangxy0803/De/prototype/连杆1-v1.SLDPRT

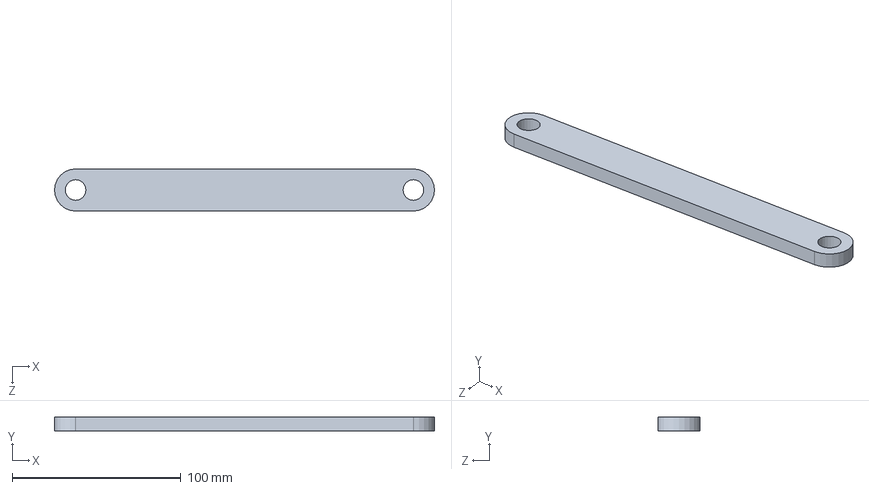
[picture p44: CAD file, 2023-10-09]
prototype/连杆1-v1.SLDPRT
225.0 x 8.00 x 25.0 mm
