wangxy0803/De/prototype/同步皮带-长.SLDPRT

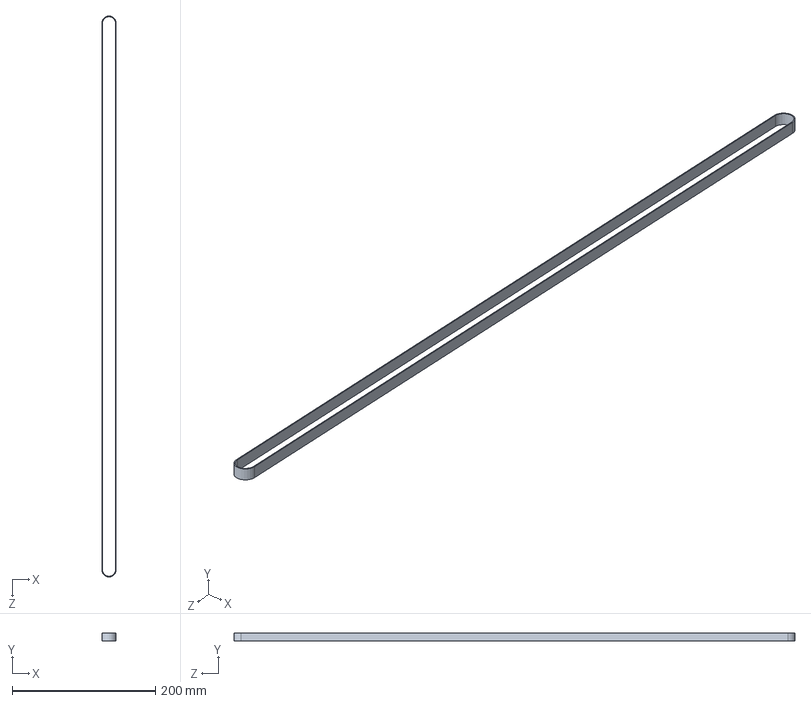
[picture p45: CAD file, 2023-10-09]
prototype/同步皮带-长.SLDPRT
20.1 x 11.0 x 782.6 mm
