wangxy0803/De/prototype/摇臂.SLDPRT

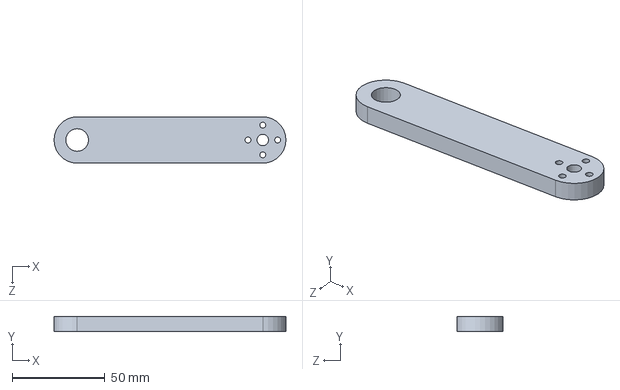
[picture p46: CAD file, 2023-10-09]
prototype/摇臂.SLDPRT
125.0 x 8.00 x 25.0 mm
