wangxy0803/De/prototype/圆柱轴5x40.SLDPRT

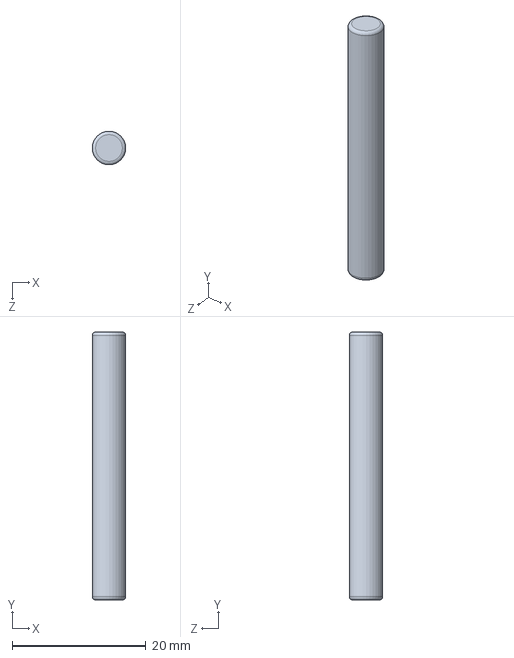
[picture p47: CAD file, 2023-10-09]
prototype/圆柱轴5x40.SLDPRT
5.00 x 40.0 x 5.00 mm
