wangxy0803/De/prototype/轴承5x14x5.SLDPRT

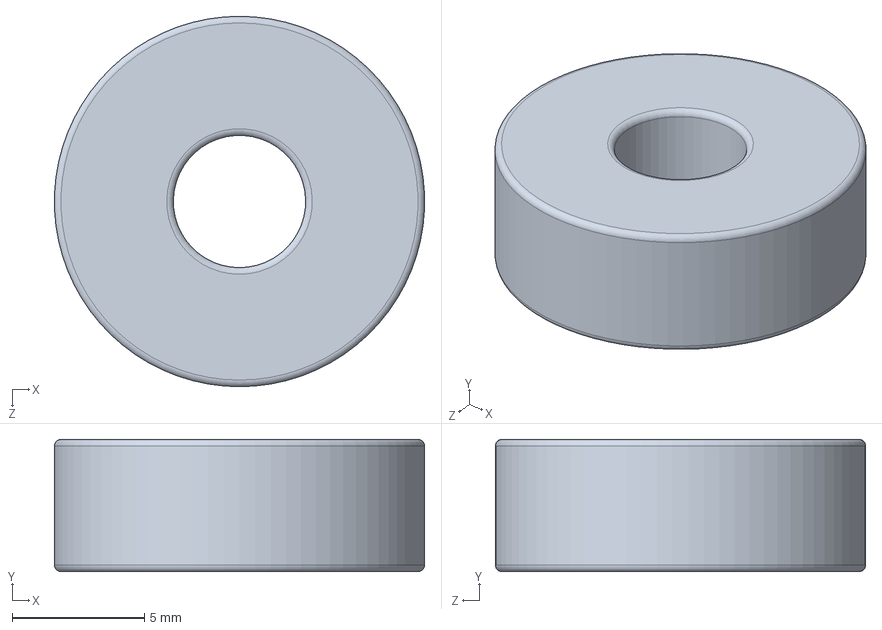
[picture p48: CAD file, 2023-10-09]
prototype/轴承5x14x5.SLDPRT
14.0 x 5.00 x 14.0 mm
