wangxy0803/De/prototype/platform.SLDPRT

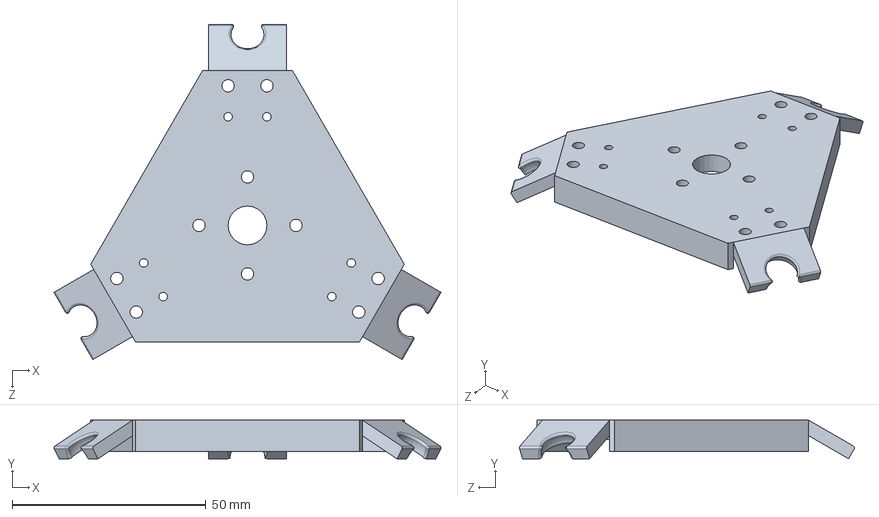
[picture p49: CAD file, 2023-10-09]
prototype/platform.SLDPRT
99.7 x 9.93 x 86.4 mm
