wangxy0803/De/prototype/同步带齿轮10齿.SLDPRT

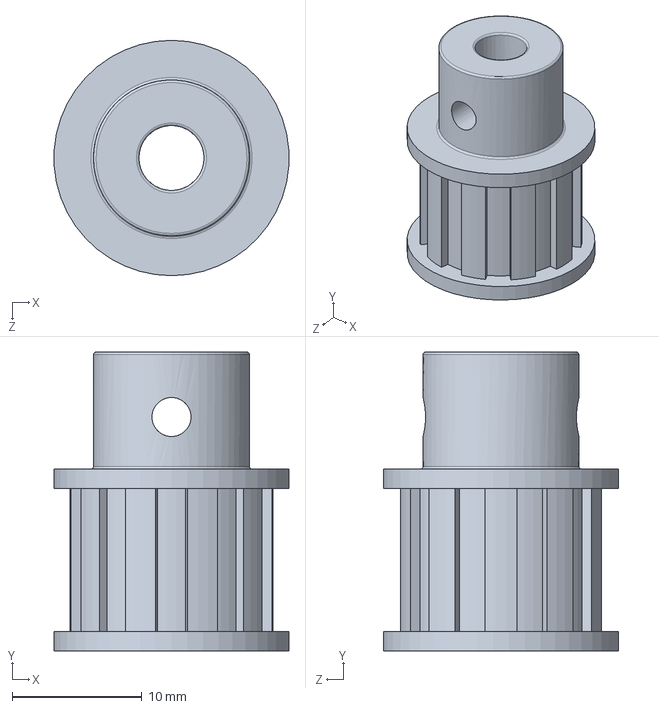
[picture p50: CAD file, 2023-10-09]
prototype/同步带齿轮10齿.SLDPRT
18.1 x 23.0 x 18.1 mm
