wangxy0803/De/prototype/底部平台-v1.SLDPRT

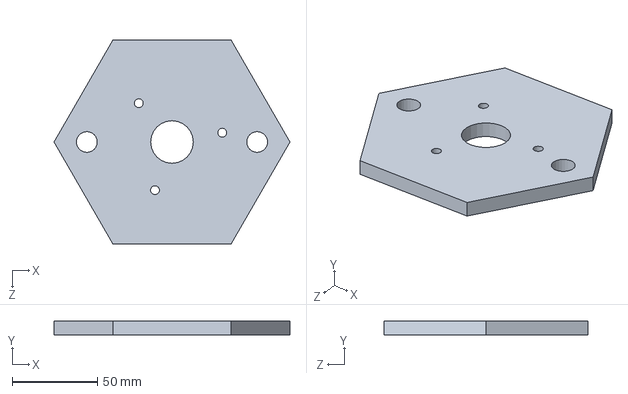
[picture p51: CAD file, 2023-10-09]
prototype/底部平台-v1.SLDPRT
138.6 x 8.00 x 120.0 mm
