wangxy0803/De/prototype/球关节摇臂.SLDPRT

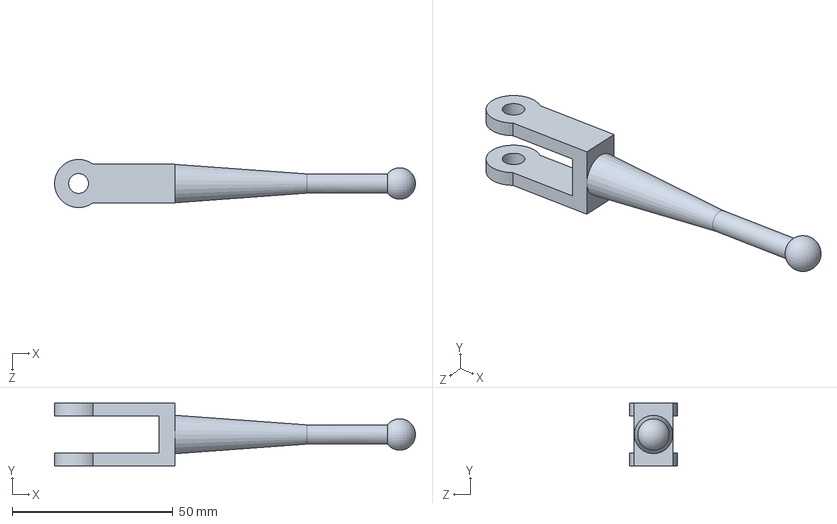
[picture p52: CAD file, 2023-10-09]
prototype/球关节摇臂.SLDPRT
112.4 x 19.6 x 15.0 mm
