wangxy0803/De/prototype/圆头螺丝M3_x45.SLDPRT

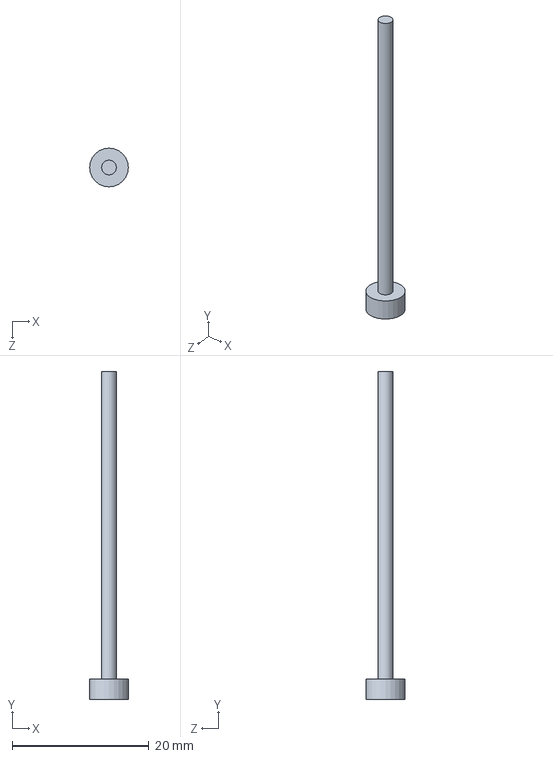
[picture p53: CAD file, 2023-10-09]
prototype/圆头螺丝M3_x45.SLDPRT
5.68 x 48.0 x 5.68 mm
