wangxy0803/De/prototype/直线导轨-HGR15.SLDPRT

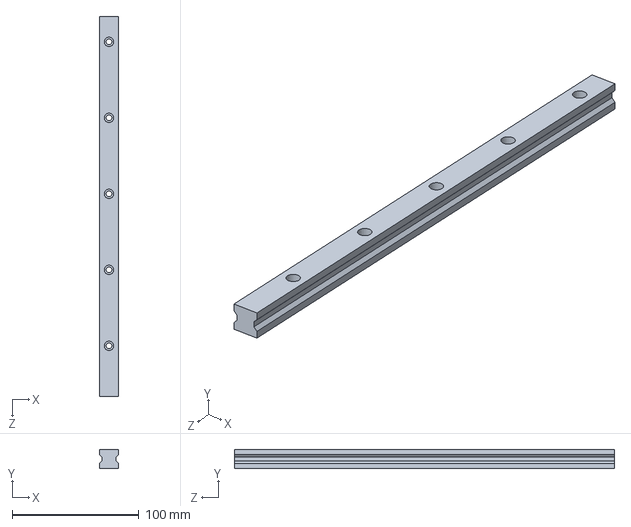
[picture p54: CAD file, 2023-10-09]
prototype/直线导轨-HGR15.SLDPRT
15.0 x 15.0 x 300.0 mm
