wangxy0803/De/prototype/滑块固定板-v1.SLDPRT

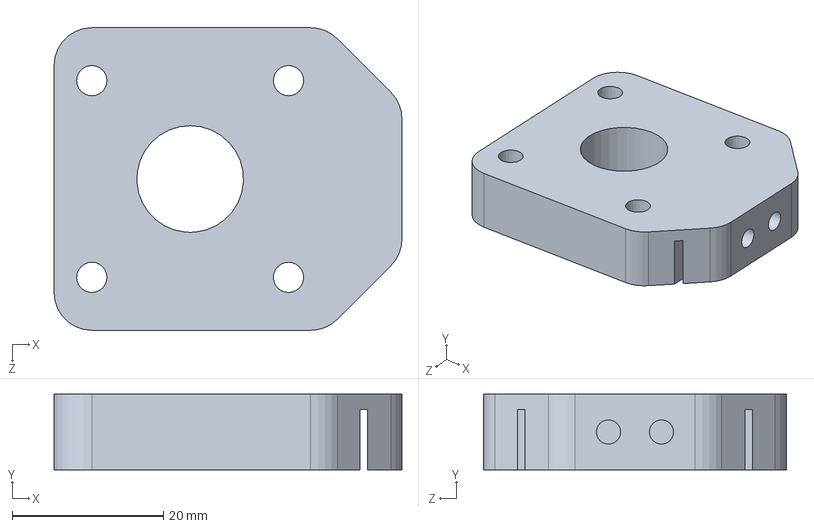
[picture p55: CAD file, 2023-10-09]
prototype/滑块固定板-v1.SLDPRT
46.0 x 10.0 x 40.0 mm
