wangxy0803/De/prototype/400mm20铝型材.SLDPRT

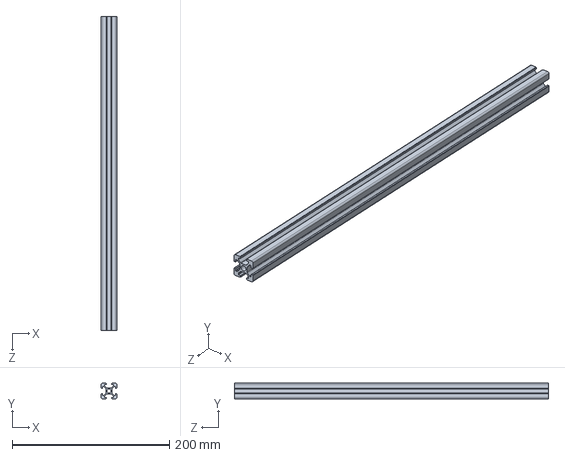
[picture p56: CAD file, 2023-10-09]
prototype/400mm20铝型材.SLDPRT
20.0 x 20.0 x 400.0 mm
