wangxy0803/De/prototype/球副2.SLDPRT

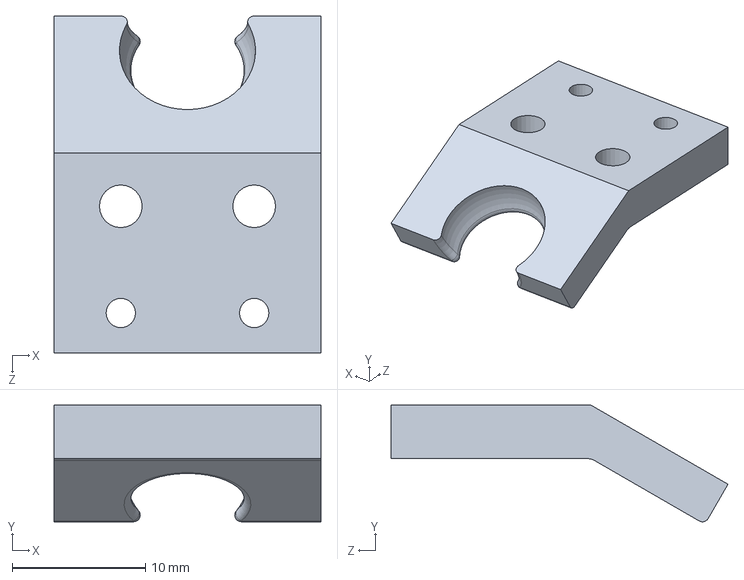
[picture p57: CAD file, 2023-10-09]
prototype/球副2.SLDPRT
20.0 x 8.74 x 25.3 mm
