wangxy0803/De/prototype/直线导轨滑块-HGH15四方形.SLDPRT

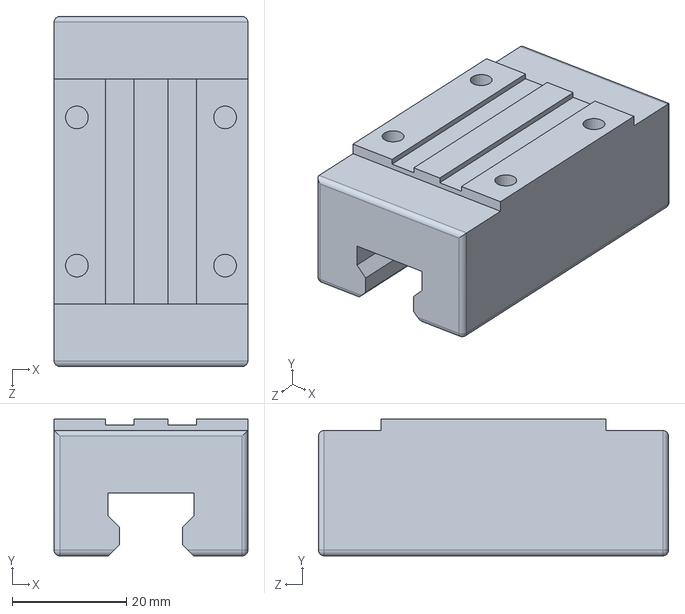
[picture p58: CAD file, 2023-10-09]
prototype/直线导轨滑块-HGH15四方形.SLDPRT
34.0 x 24.0 x 61.4 mm
