wangxy0803/De/prototype/同步皮带.SLDPRT

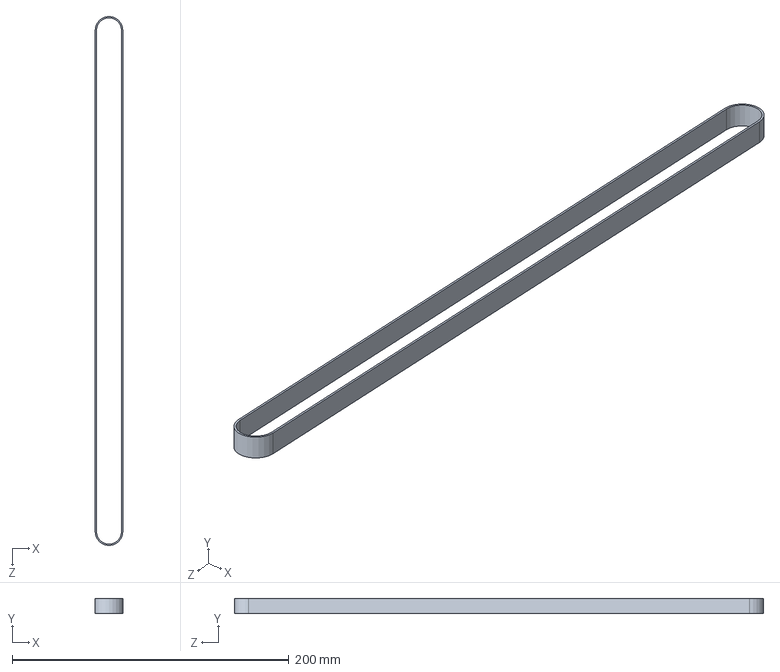
[picture p59: CAD file, 2023-10-09]
prototype/同步皮带.SLDPRT
20.1 x 11.0 x 382.6 mm
