wangxy0803/De/prototype/定平台2.SLDPRT

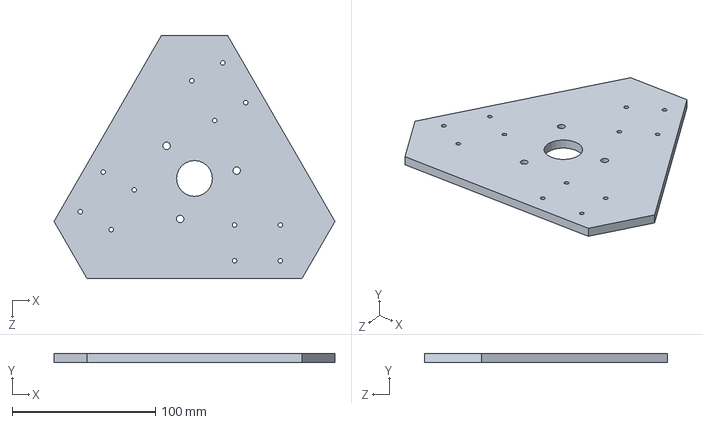
[picture p60: CAD file, 2023-10-09]
prototype/定平台2.SLDPRT
196.3 x 6.00 x 170.0 mm
