wangxy0803/De/prototype/M6防松螺母.SLDPRT

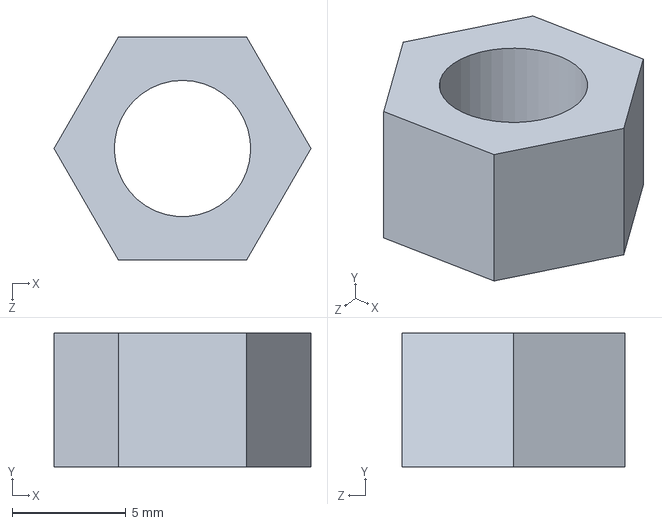
[picture p61: CAD file, 2023-10-09]
prototype/M6防松螺母.SLDPRT
11.3 x 5.90 x 9.80 mm
