wangxy0803/De/prototype/同步齿轮固定板-v1.SLDPRT

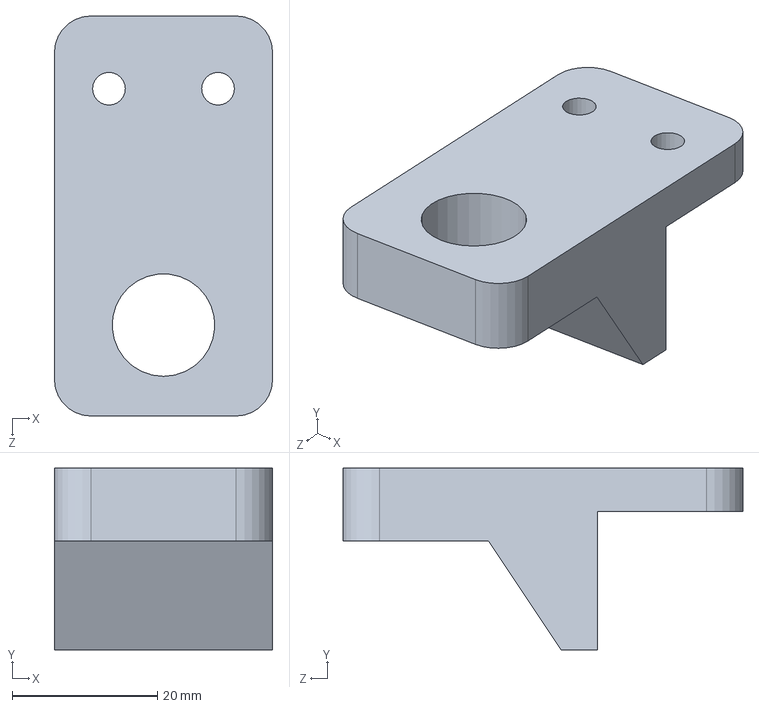
[picture p62: CAD file, 2023-10-09]
prototype/同步齿轮固定板-v1.SLDPRT
30.0 x 25.0 x 55.0 mm
