wangxy0803/De/prototype/300mm20铝型材.SLDPRT

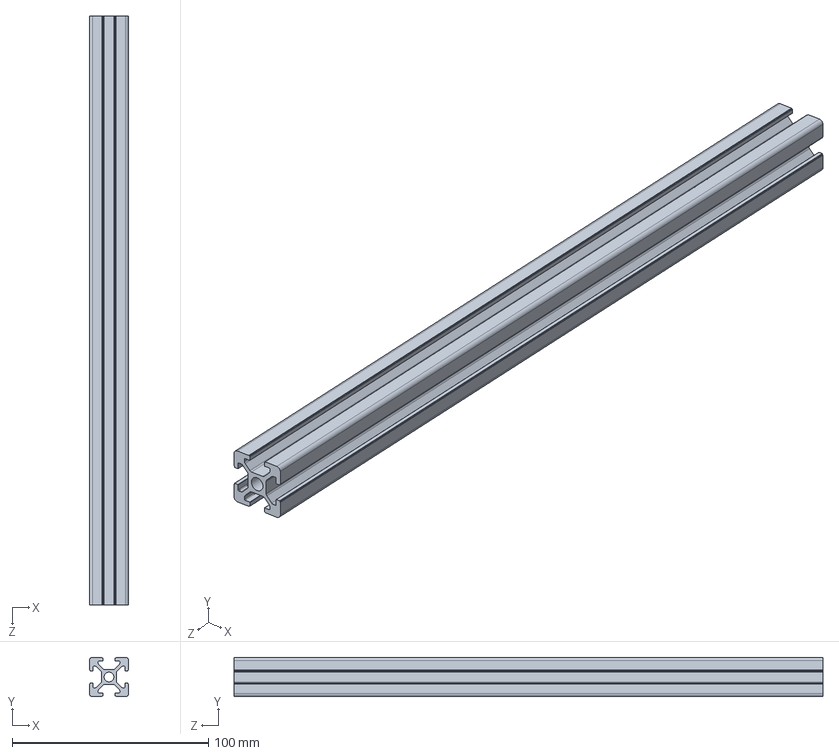
[picture p63: CAD file, 2023-10-09]
prototype/300mm20铝型材.SLDPRT
20.0 x 20.0 x 300.0 mm
