wangxy0803/De/prototype/T型螺母-20系列M4x10x6x5.SLDPRT

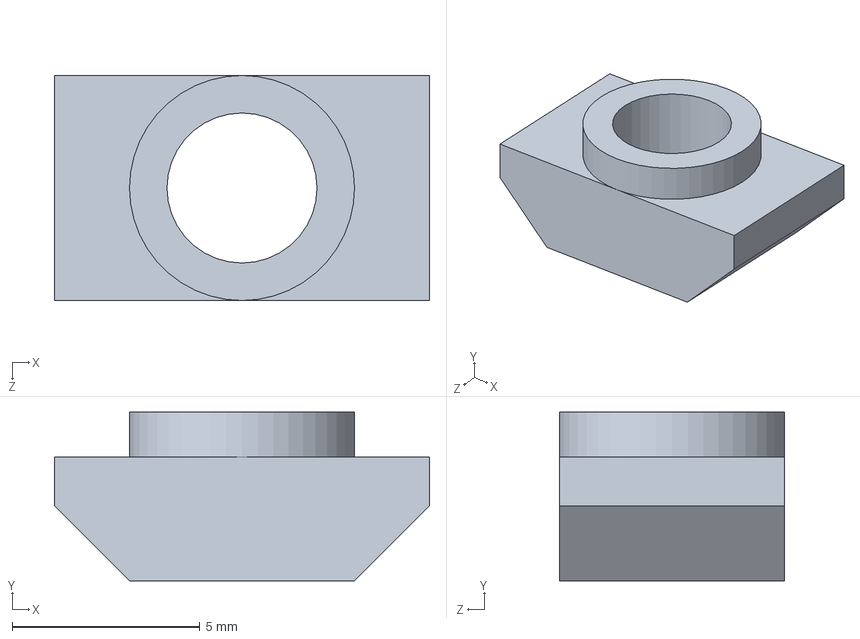
[picture p64: CAD file, 2023-10-09]
prototype/T型螺母-20系列M4x10x6x5.SLDPRT
10.0 x 4.50 x 6.00 mm
