wangxy0803/De/prototype/滑块连接件-高.SLDPRT

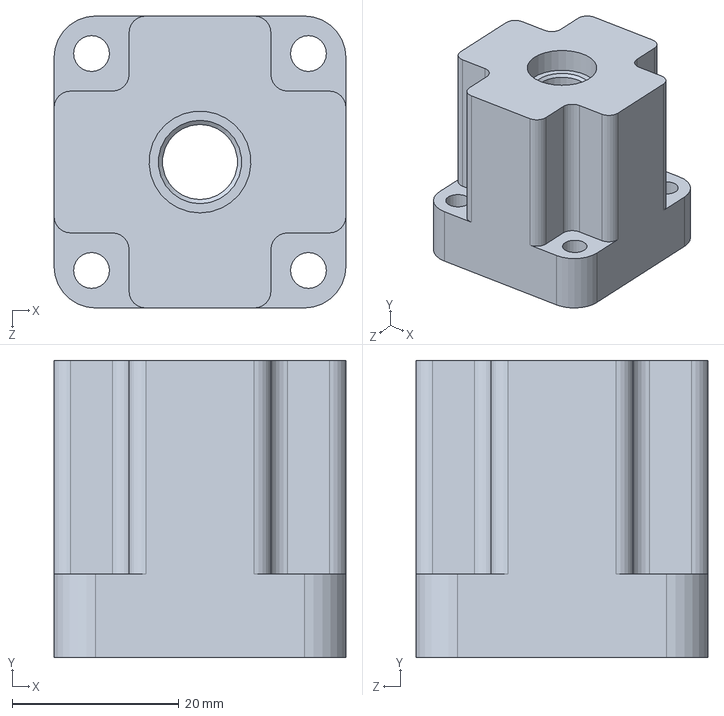
[picture p65: CAD file, 2023-10-09]
prototype/滑块连接件-高.SLDPRT
35.0 x 35.6 x 35.0 mm
