wangxy0803/De/prototype/滑块连接件.SLDPRT

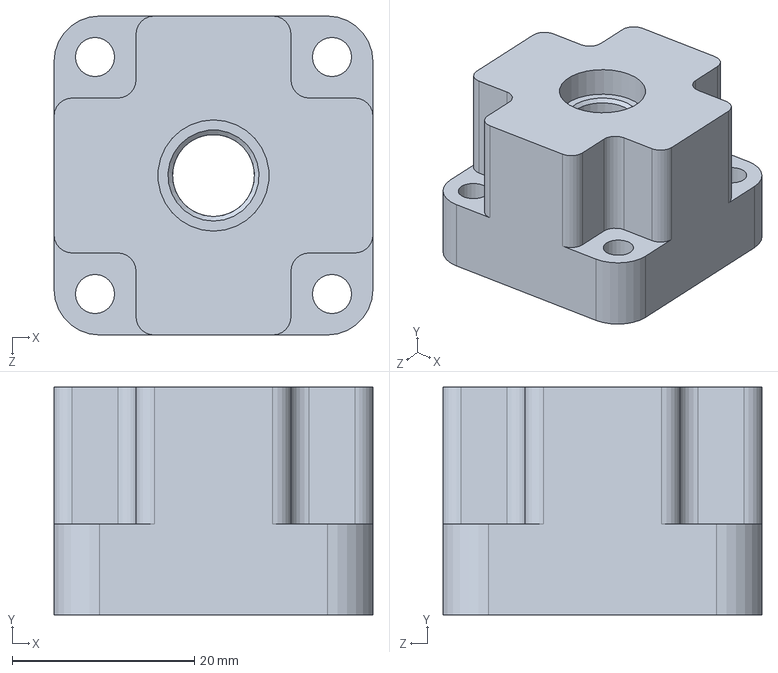
[picture p66: CAD file, 2023-10-09]
prototype/滑块连接件.SLDPRT
35.0 x 25.0 x 35.0 mm
