wangxy0803/De/prototype/法兰盘.SLDPRT

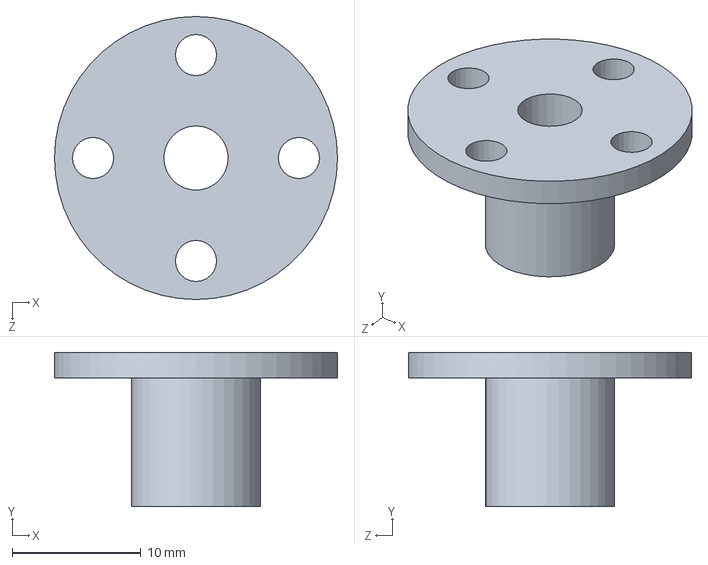
[picture p67: CAD file, 2023-10-09]
prototype/法兰盘.SLDPRT
22.0 x 12.0 x 22.0 mm
