wangxy0803/De/prototype/800mm20铝型材.SLDPRT

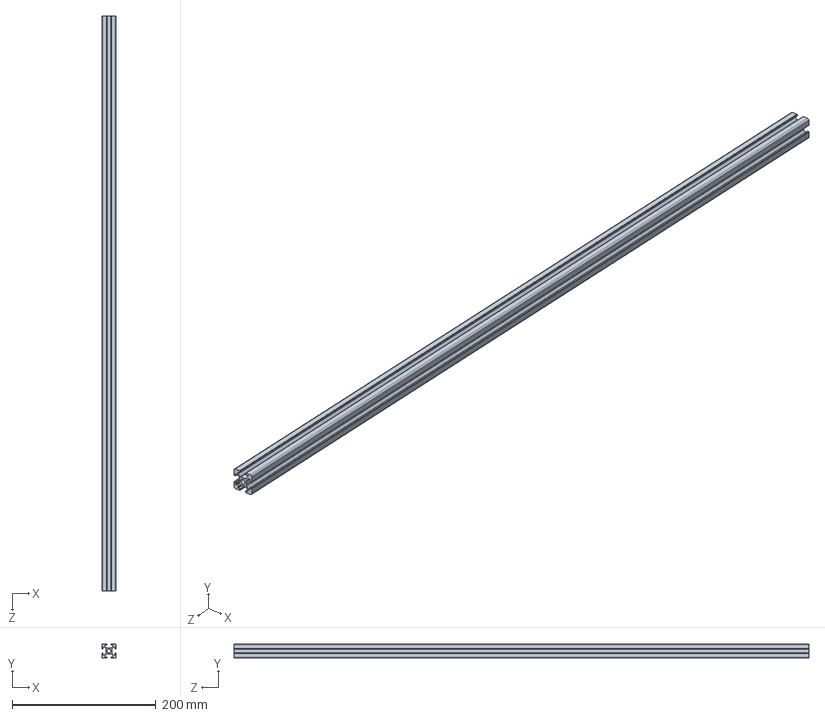
[picture p68: CAD file, 2023-10-09]
prototype/800mm20铝型材.SLDPRT
20.0 x 20.0 x 800.0 mm
