wangxy0803/De/prototype/6-12-4法兰轴承.SLDPRT

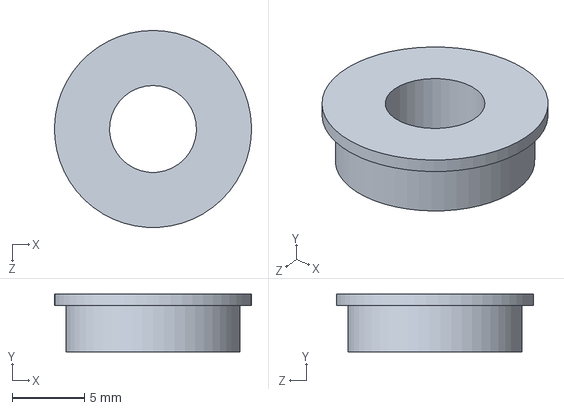
[picture p69: CAD file, 2023-10-09]
prototype/6-12-4法兰轴承.SLDPRT
13.6 x 4.00 x 13.6 mm
