wangxy0803/De/prototype/M6垫片.SLDPRT

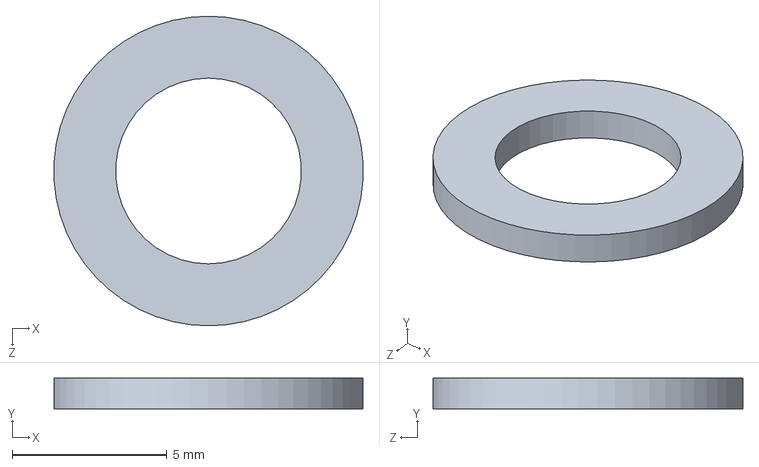
[picture p70: CAD file, 2023-10-09]
prototype/M6垫片.SLDPRT
9.98 x 1.00 x 10.0 mm
