wangxy0803/De/prototype/圆头螺丝M4x10.SLDPRT

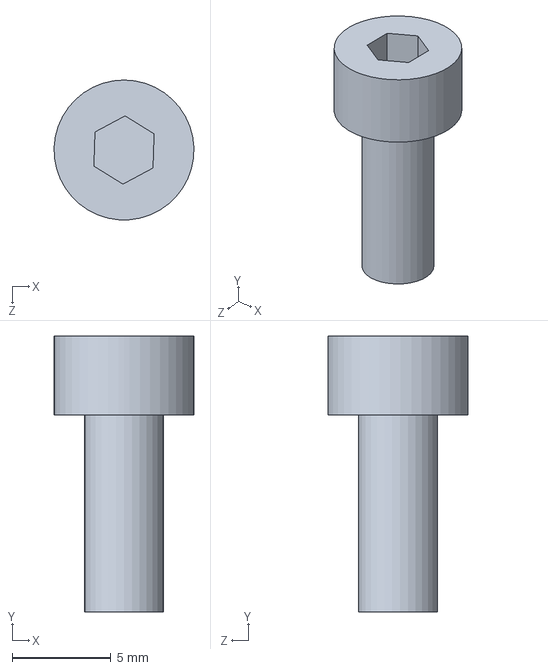
[picture p71: CAD file, 2023-10-09]
prototype/圆头螺丝M4x10.SLDPRT
7.09 x 14.0 x 7.10 mm
