wangxy0803/De/prototype/步进电机支架.SLDPRT

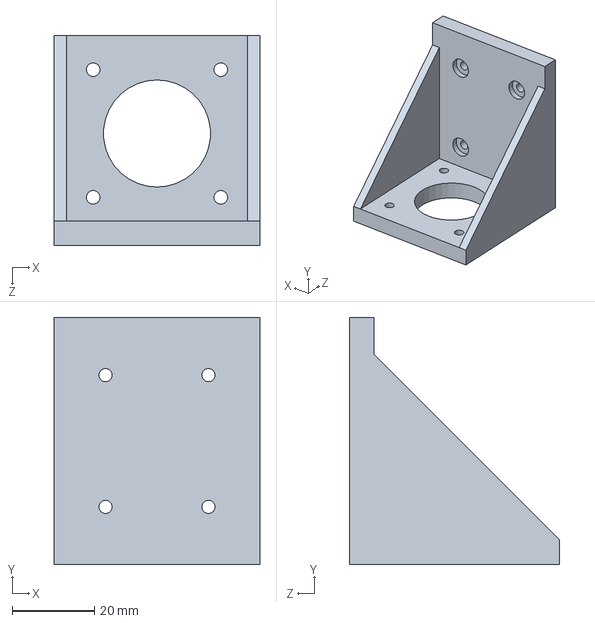
[picture p72: CAD file, 2023-10-09]
prototype/步进电机支架.SLDPRT
50.0 x 60.0 x 51.0 mm
