wangxy0803/De/prototype/圆头螺丝M4x16.SLDPRT

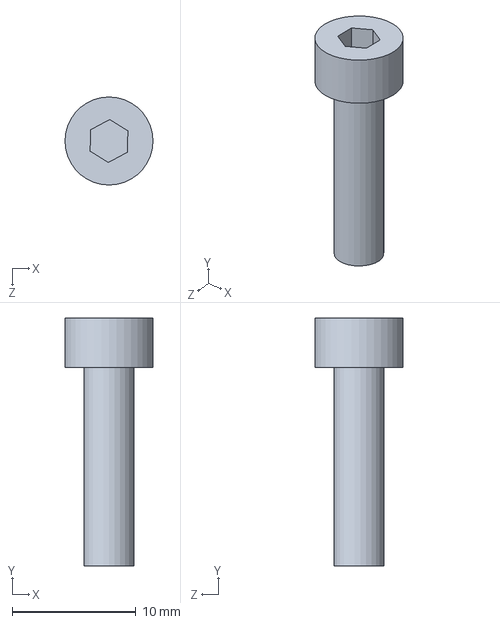
[picture p73: CAD file, 2023-10-09]
prototype/圆头螺丝M4x16.SLDPRT
7.10 x 20.0 x 7.10 mm
