wangxy0803/De/prototype/42步进电机固定板-v1.SLDPRT

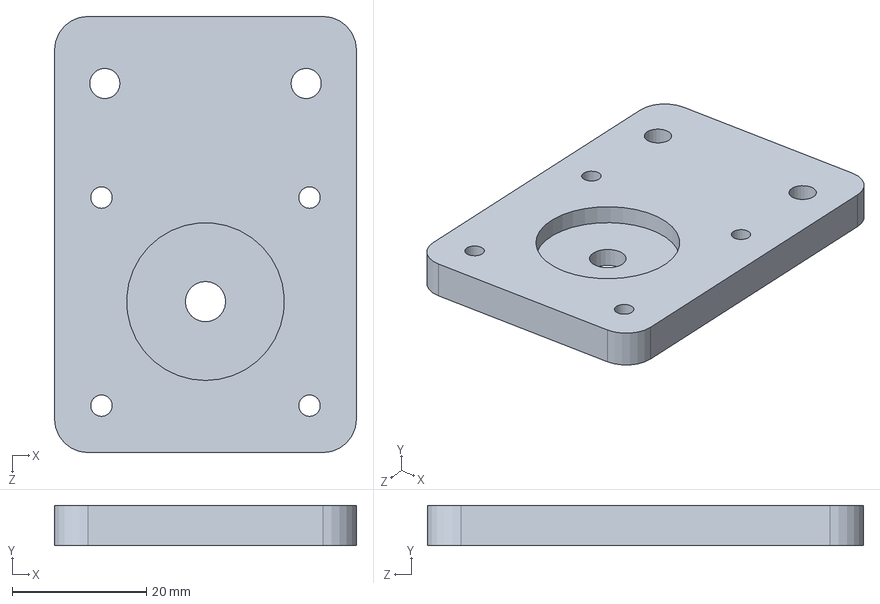
[picture p74: CAD file, 2023-10-09]
prototype/42步进电机固定板-v1.SLDPRT
45.0 x 6.00 x 65.0 mm
