wangxy0803/De/(list of files, cad)

Other CAD files:
prototype/组合-六自由度机器人-散.SLDASM
prototype/42步进电机.SLDPRT
code/skull.obj
prototype/M6-25螺丝.SLDPRT
prototype/M6-30螺丝.SLDPRT
prototype/M6-35螺丝.SLDPRT
prototype/M6-40螺丝.SLDPRT
prototype/Nut_M3.SLDPRT
prototype/Washer_3x7x05.SLDPRT
prototype/组合-线性关节-v1-组合用.SLDASM
